fullyautomated/means-of-circuit-design/3D/PowerPak_1212-8/README.md

Source: [https://grabcad.com/library/powerpak_1212-8_single_pad-1]
