fullyautomated/means-of-circuit-design/3D/USB-C/README.md

Source: [https://grabcad.com/library/type-c-31-m-12-1] 

This is not the exact part the footprint is for, but it seems to fit rather well.
