fullyautomated/means-of-circuit-design/3D/PCIe/SMT_POST_36_ASM_sp.step

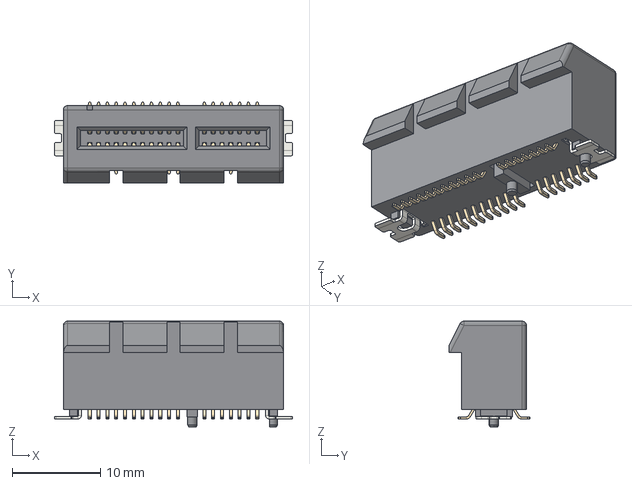
[picture p1: CAD file, 2020-07-23]
3D/PCIe/SMT_POST_36_ASM_sp.step
27.0 x 9.20 x 12.0 mm
