fullyautomated/means-of-circuit-design/3D/Bourns/SRR5028.step

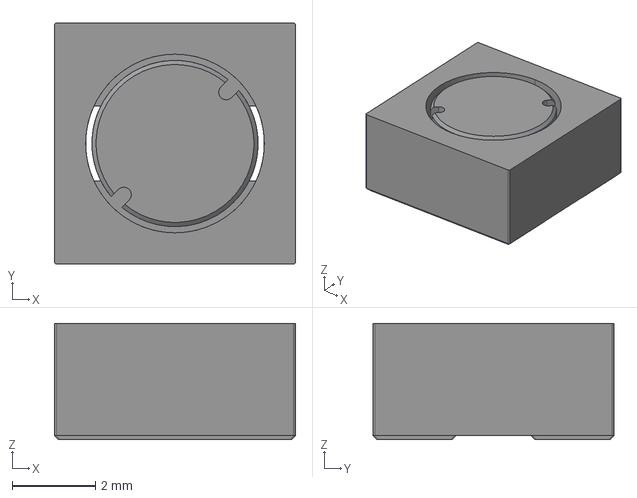
[picture p2: CAD file, 2021-05-05]
3D/Bourns/SRR5028.step
5.80 x 5.80 x 2.80 mm
