fullyautomated/means-of-circuit-design/3D/BQ25792/model.FCStd

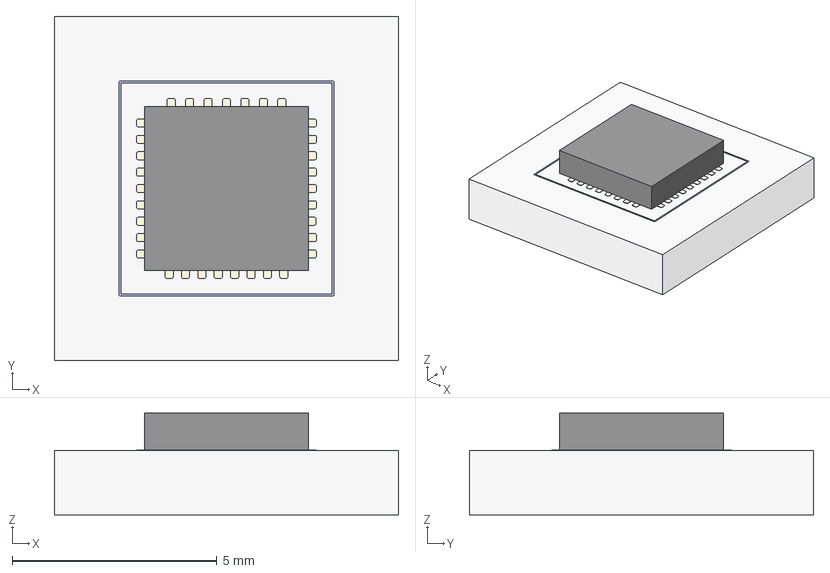
[picture p3: CAD file, 2020-07-23]
3D/BQ25792/model.FCStd
8.40 x 8.40 x 2.49 mm
FCrtYd
TopPads
Pcb
