fullyautomated/means-of-circuit-design/3D/Coilcraft/SER2211.FCStd

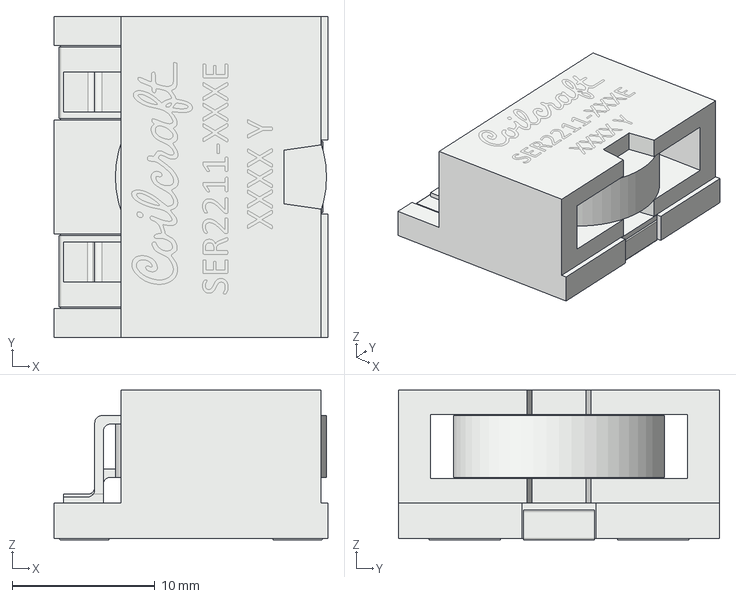
[picture p4: CAD file, 2021-05-05]
3D/Coilcraft/SER2211.FCStd
19.2 x 22.5 x 10.5 mm
