fullyautomated/means-of-circuit-design/3D/DCJack/2.5mm.FCStd

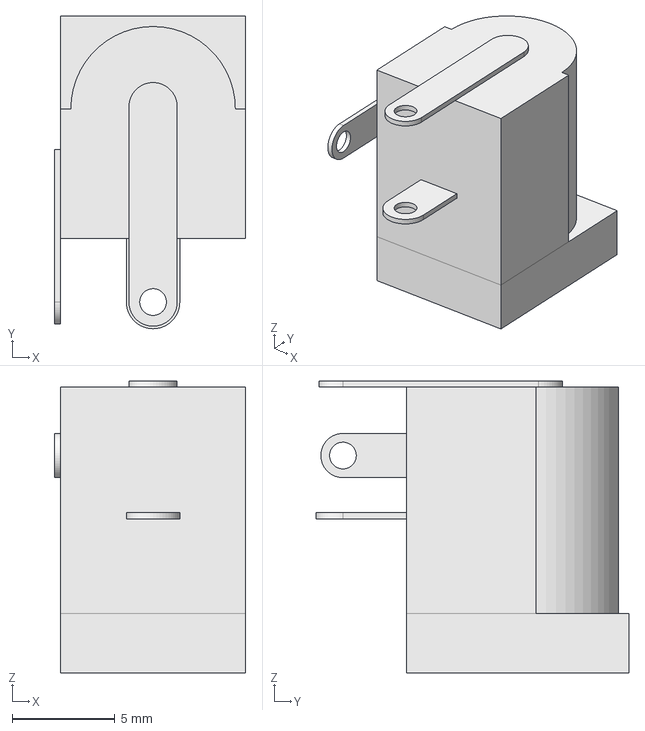
[picture p5: CAD file, 2020-06-24]
3D/DCJack/2.5mm.FCStd
9.30 x 15.2 x 14.2 mm
