fullyautomated/means-of-circuit-design/3D/DSOP_Advance/body.step

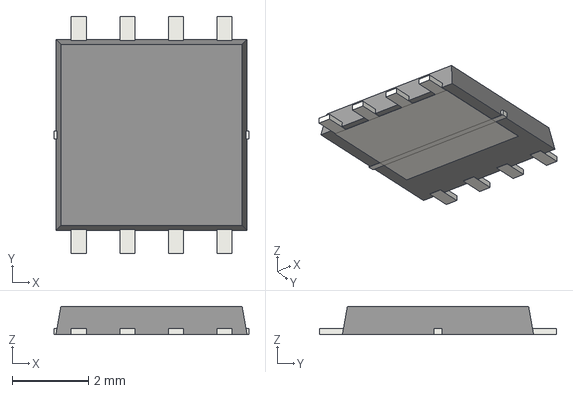
[picture p6: CAD file, 2020-06-24]
3D/DSOP_Advance/body.step
5.10 x 6.20 x 0.74 mm
