fullyautomated/means-of-circuit-design/3D/ESP8266/ESP8266-12.FCStd

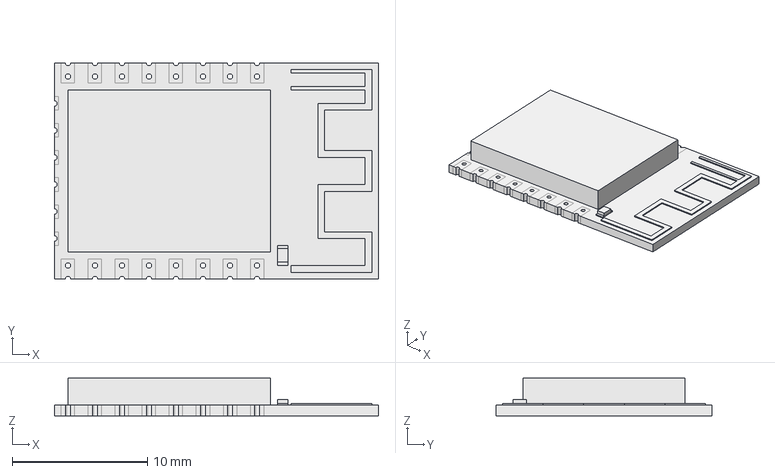
[picture p7: CAD file, 2020-06-24]
3D/ESP8266/ESP8266-12.FCStd
24.0 x 16.0 x 2.80 mm
