fullyautomated/means-of-circuit-design/3D/FastON/FastON_6.3mm_PCBmount_RightAngle_Osterrath_61-1573-11_0031.step

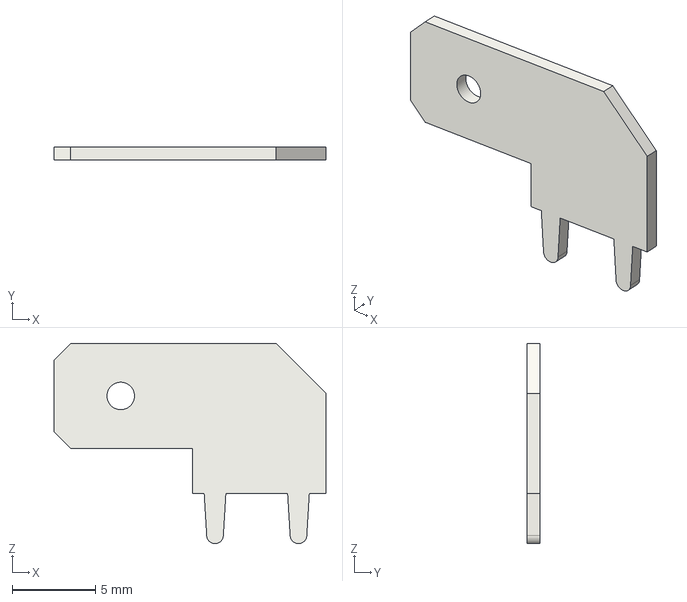
[picture p8: CAD file, 2021-01-31]
3D/FastON/FastON_6.3mm_PCBmount_RightAngle_Osterrath_61-1573-11_0031.step
16.3 x 0.8 x 12.0 mm
