fullyautomated/means-of-circuit-design/3D/Generic/SOT428.step

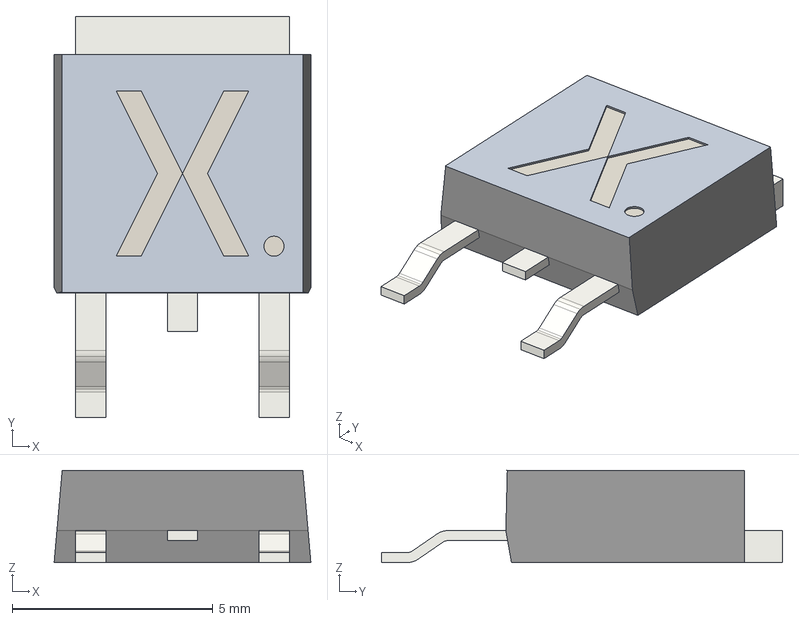
[picture p9: CAD file, 2020-08-01]
3D/Generic/SOT428.step
6.40 x 10.0 x 2.30 mm
