fullyautomated/means-of-circuit-design/3D/Heatsink/960-23-23-D-AB-0.step

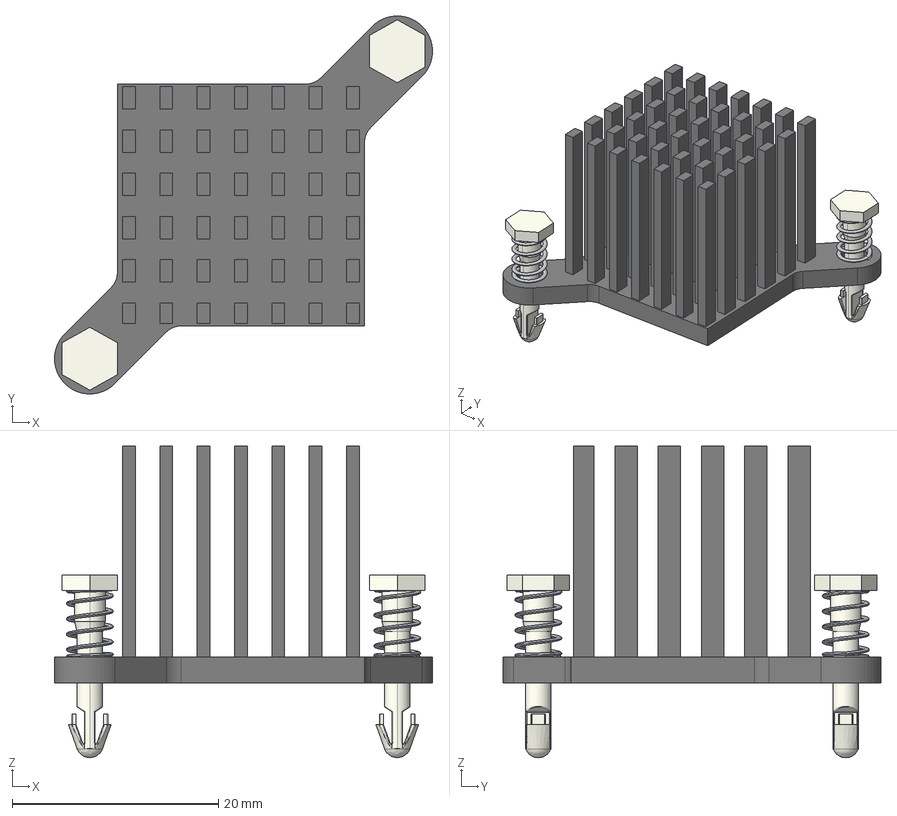
[picture p10: CAD file, 2020-08-03]
3D/Heatsink/960-23-23-D-AB-0.step
36.7 x 36.7 x 30.2 mm
