fullyautomated/means-of-circuit-design/3D/Hirose/WNCB-2000021.stp

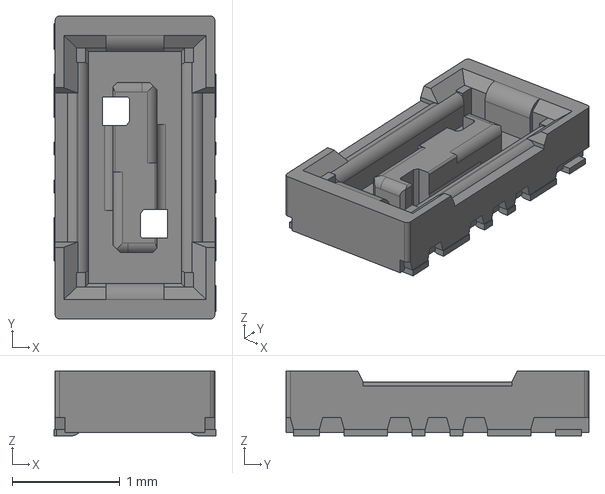
[picture p11: CAD file, 2026-10-10]
3D/Hirose/WNCB-2000021.stp
1.50 x 2.81 x 0.6 mm
