fullyautomated/means-of-circuit-design/3D/Housing/CNMB-CB_Base_cp.step

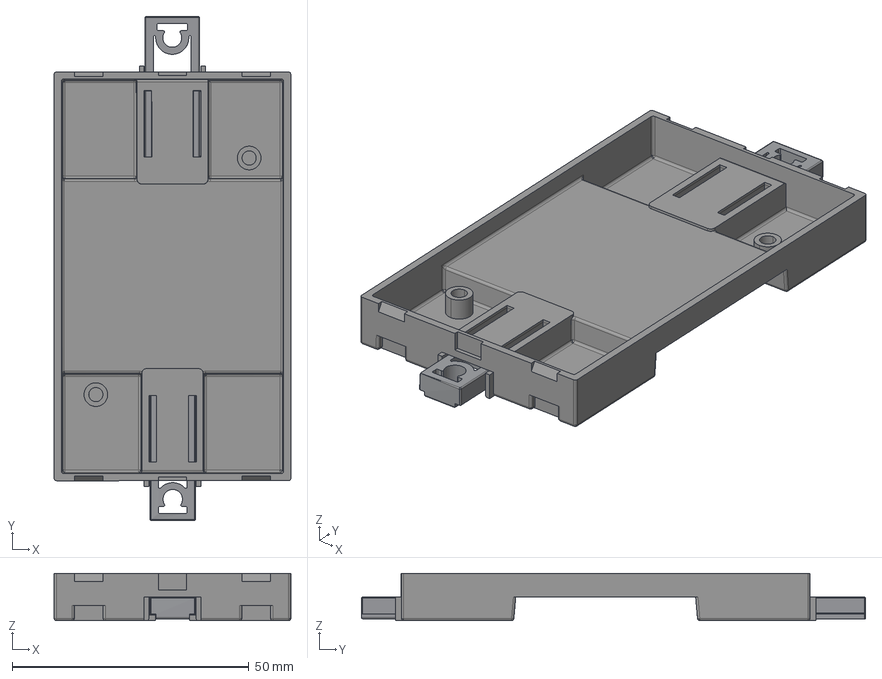
[picture p12: CAD file, 2020-07-31]
3D/Housing/CNMB-CB_Base_cp.step
50.0 x 106.5 x 10.0 mm
