fullyautomated/means-of-circuit-design/3D/JST/SM04B-ULHK-1GFA1-ETB(HF).STEP

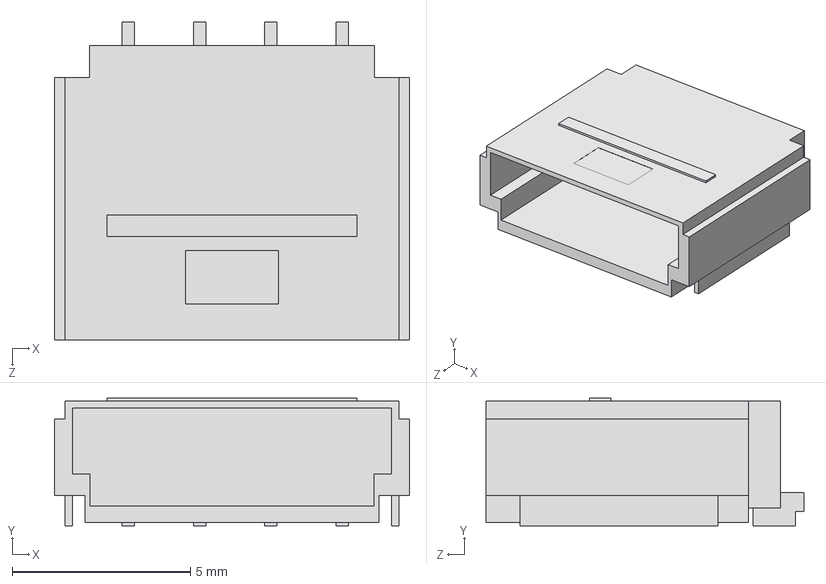
[picture p13: CAD file, 2026-10-10]
3D/JST/SM04B-ULHK-1GFA1-ETB(HF).STEP
9.95 x 3.58 x 8.90 mm
