fullyautomated/means-of-circuit-design/3D/LEDs/LM301H.step

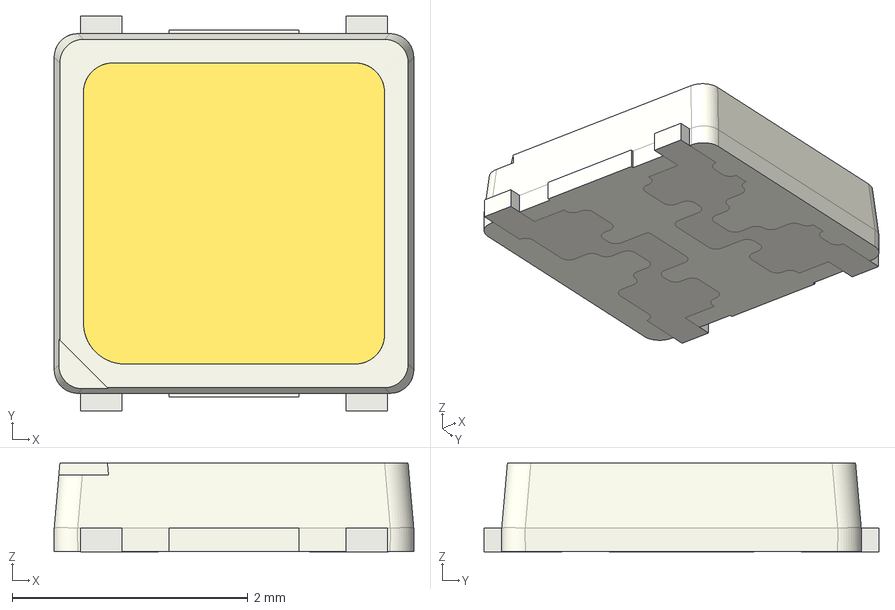
[picture p14: CAD file, 2021-02-14]
3D/LEDs/LM301H.step
3.05 x 3.35 x 0.751 mm
