fullyautomated/means-of-circuit-design/3D/Murata/DLW5BSM191SQ2L.step

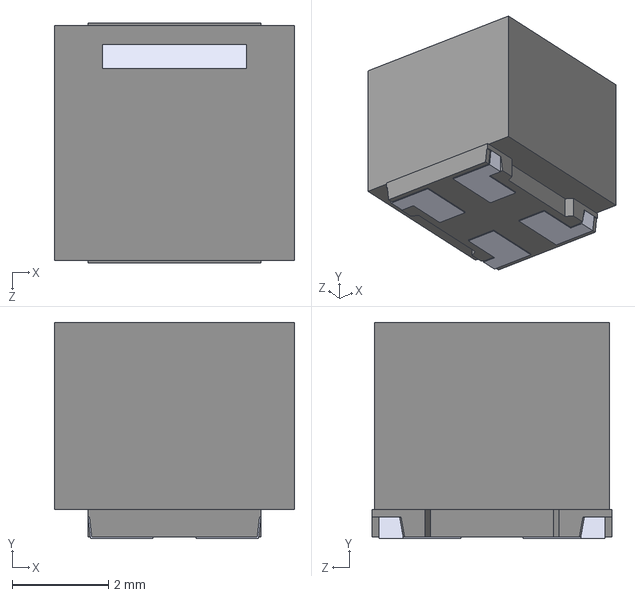
[picture p15: CAD file, 2020-12-17]
3D/Murata/DLW5BSM191SQ2L.step
5.00 x 4.50 x 5.00 mm
