fullyautomated/means-of-circuit-design/3D/Panasonic_PCC-M0530M/M0530M.fcstd

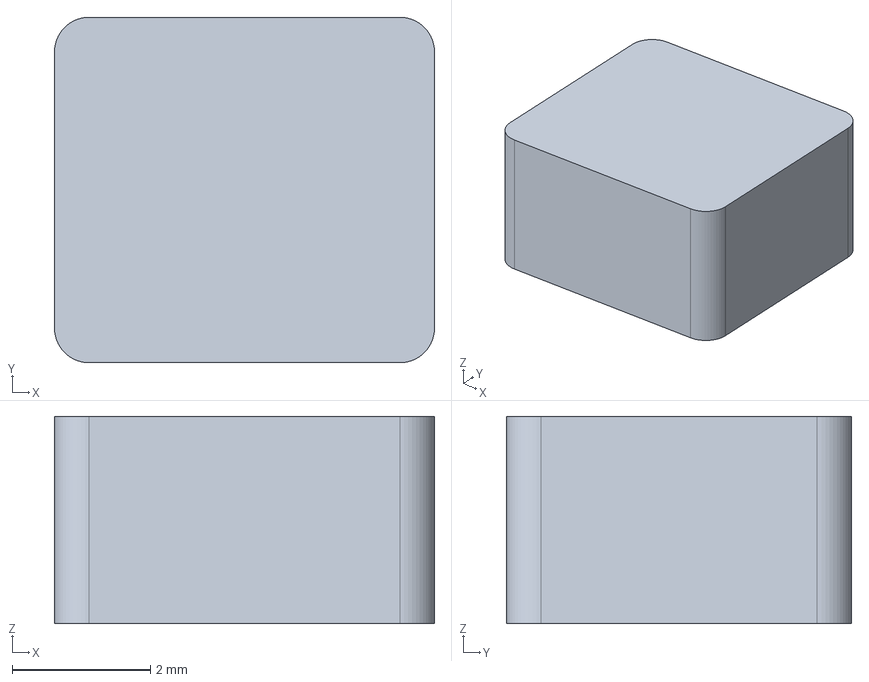
[picture p16: CAD file, 2020-06-24]
3D/Panasonic_PCC-M0530M/M0530M.fcstd
5.50 x 5.00 x 3.00 mm
