fullyautomated/means-of-circuit-design/3D/PCIe/Amphenol_10018783-10210TLF.FCStd

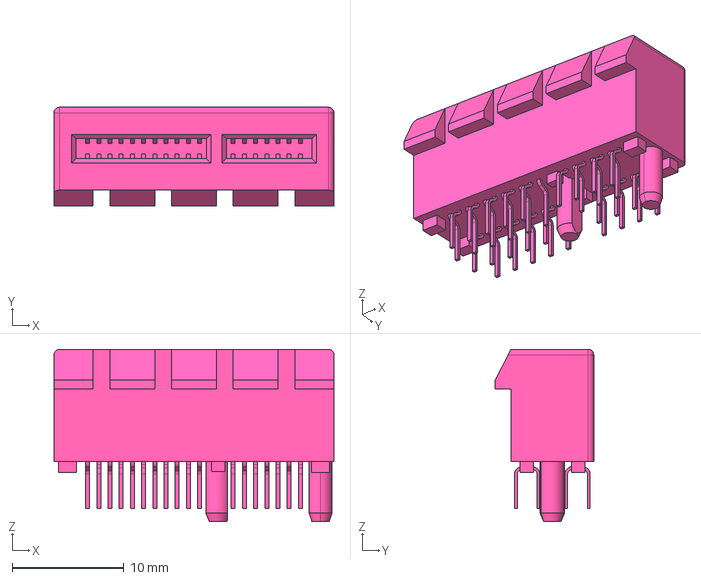
[picture p17: CAD file, 2020-08-02]
3D/PCIe/Amphenol_10018783-10210TLF.FCStd
25.0 x 8.80 x 15.4 mm
