fullyautomated/means-of-circuit-design/3D/PhoenixContact/ccva_2.5-2-g-5.08_p26_thr001_sp.step

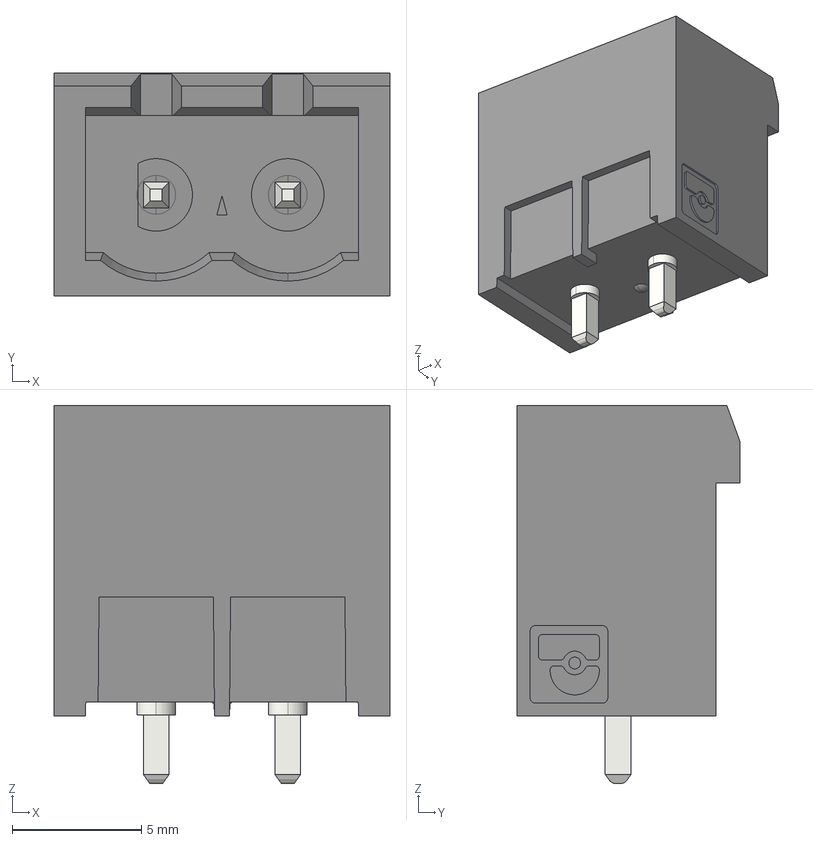
[picture p18: CAD file, 2020-07-23]
3D/PhoenixContact/ccva_2.5-2-g-5.08_p26_thr001_sp.step
13.0 x 8.60 x 14.6 mm
