fullyautomated/means-of-circuit-design/3D/PowerPak_1212-8/PowerPAK_1212-8.step

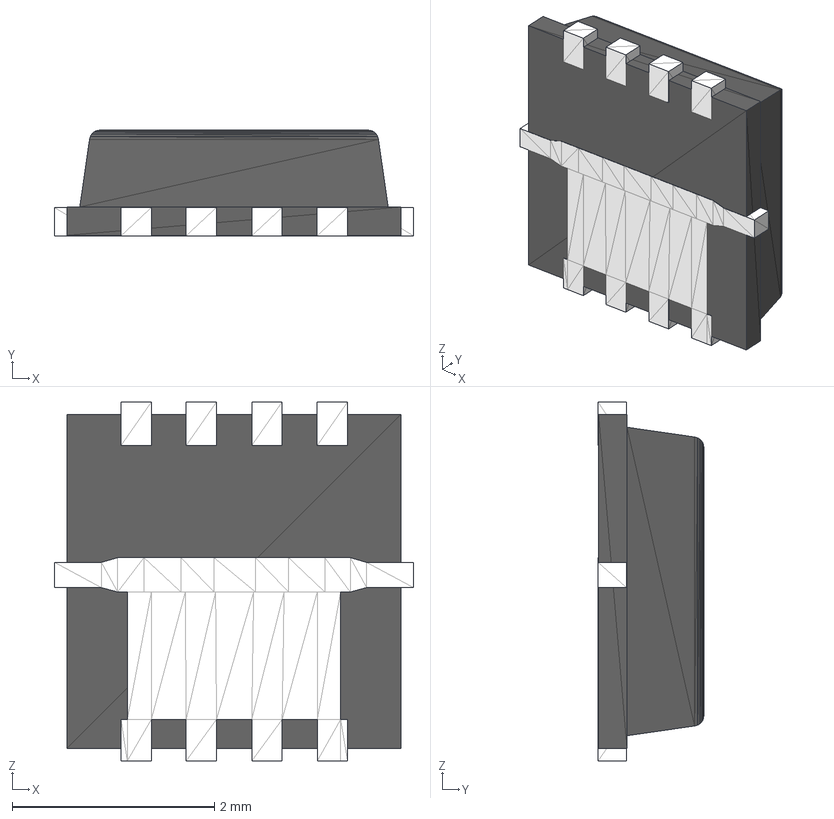
[picture p19: CAD file, 2020-07-23]
3D/PowerPak_1212-8/PowerPAK_1212-8.step
3.55 x 1.05 x 3.55 mm
