fullyautomated/means-of-circuit-design/3D/PTS636/PTS636.FCStd

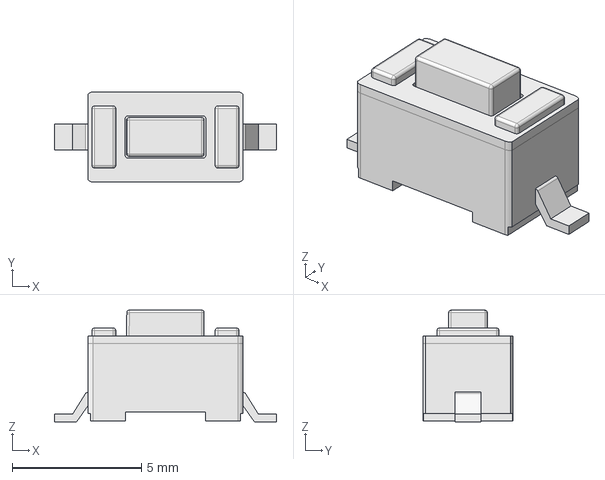
[picture p20: CAD file, 2020-07-23]
3D/PTS636/PTS636.FCStd
8.60 x 3.50 x 4.33 mm
