fullyautomated/means-of-circuit-design/3D/QFN-20-1EP_3x3mm_P0.4mm_EP1.65x1.65mm/QFN40P300X300X75-21T170N.step

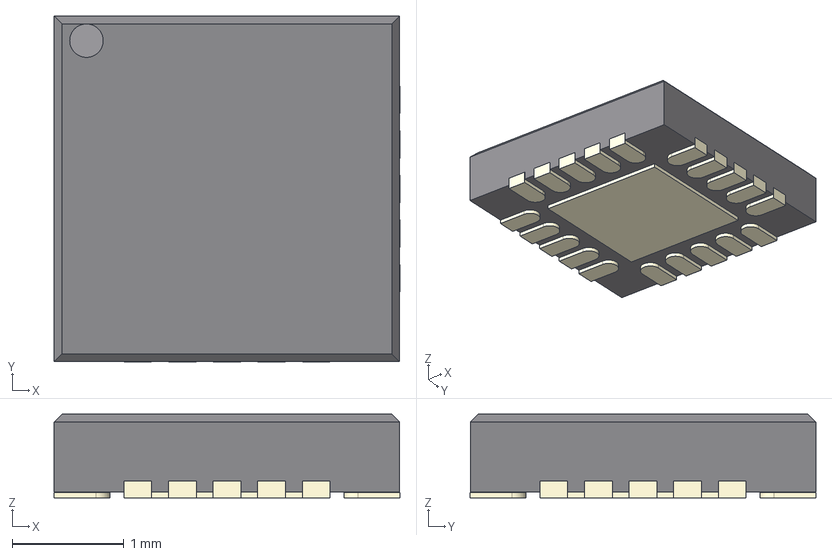
[picture p21: CAD file, 2020-07-23]
3D/QFN-20-1EP_3x3mm_P0.4mm_EP1.65x1.65mm/QFN40P300X300X75-21T170N.step
3.10 x 3.10 x 0.75 mm
