fullyautomated/means-of-circuit-design/3D/Samtec/tsw-113-08-t-t-ra.step

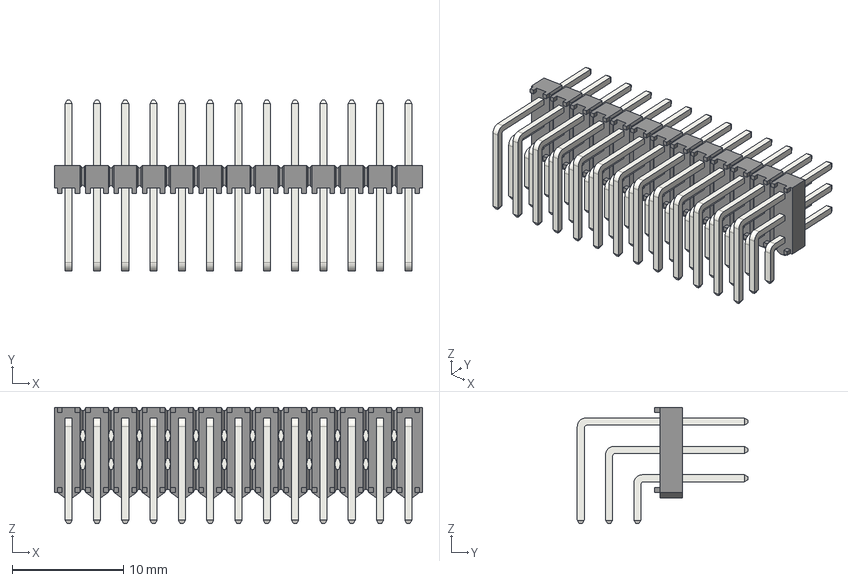
[picture p22: CAD file, 2020-08-03]
3D/Samtec/tsw-113-08-t-t-ra.step
33.0 x 15.3 x 10.4 mm
