fullyautomated/means-of-circuit-design/3D/Sensors/LTR-303ALS-01.step

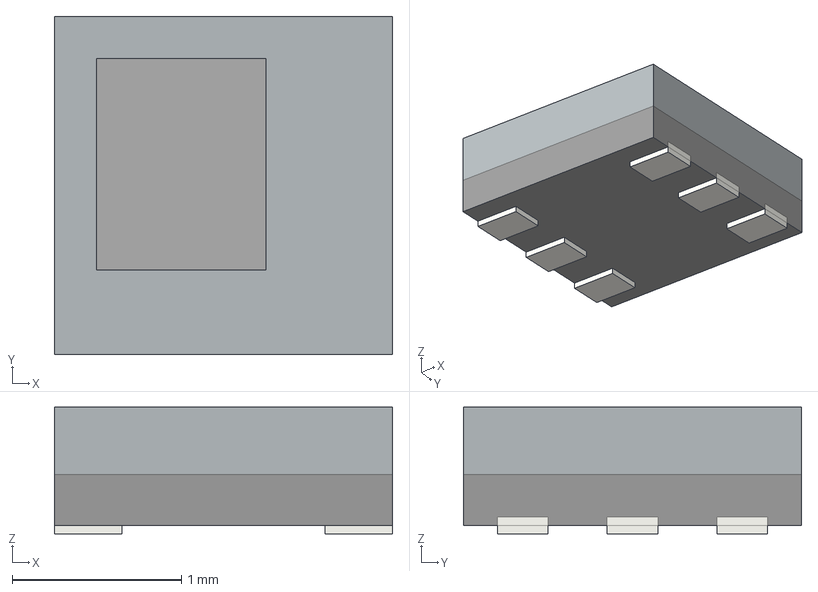
[picture p23: CAD file, 2020-08-25]
3D/Sensors/LTR-303ALS-01.step
2.00 x 2.00 x 0.75 mm
