fullyautomated/means-of-circuit-design/3D/SRP1245/Admi4FFDtvdj.step

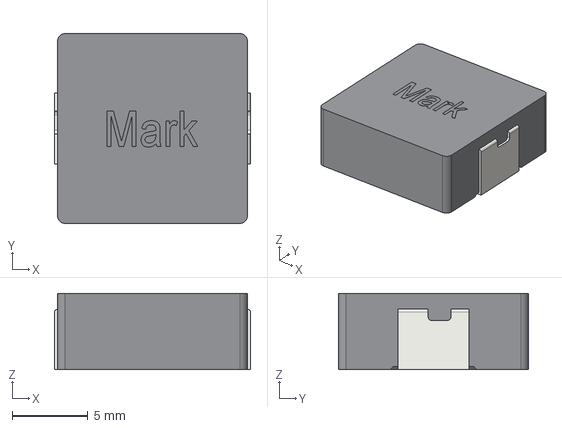
[picture p24: CAD file, 2020-07-23]
3D/SRP1245/Admi4FFDtvdj.step
12.9 x 12.5 x 5.00 mm
