fullyautomated/means-of-circuit-design/3D/TI/RPE0009A.step

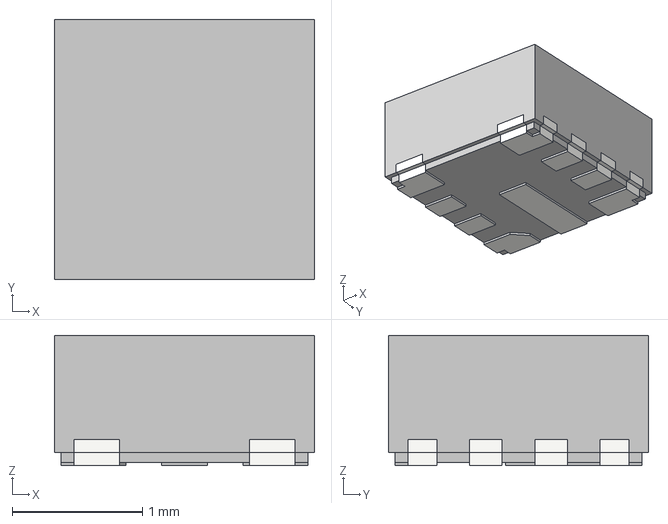
[picture p25: CAD file, 2021-05-03]
3D/TI/RPE0009A.step
2.00 x 2.00 x 1.00 mm
