fullyautomated/means-of-circuit-design/3D/Toshiba/TO-220SM(W).step

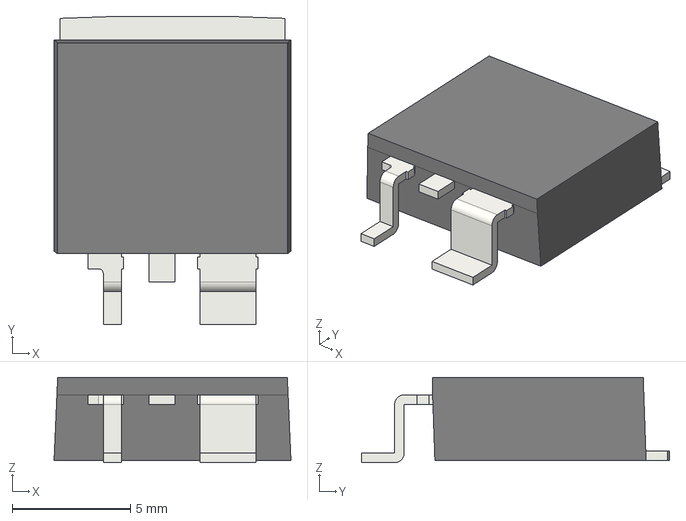
[picture p26: CAD file, 2021-02-14]
3D/Toshiba/TO-220SM(W).step
10.0 x 13.0 x 3.60 mm
