fullyautomated/means-of-circuit-design/3D/TPS62135/Pad.step

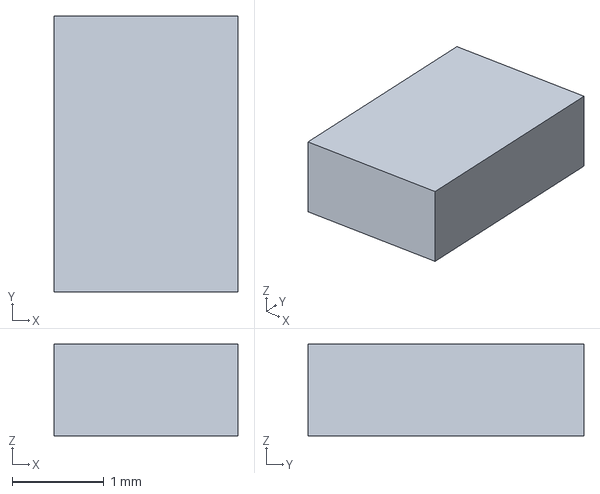
[picture p27: CAD file, 2020-06-24]
3D/TPS62135/Pad.step
2.00 x 3.00 x 1.00 mm
