fullyautomated/means-of-circuit-design/3D/USB-C/HRO_TYPE-C-31-M-12_source.step

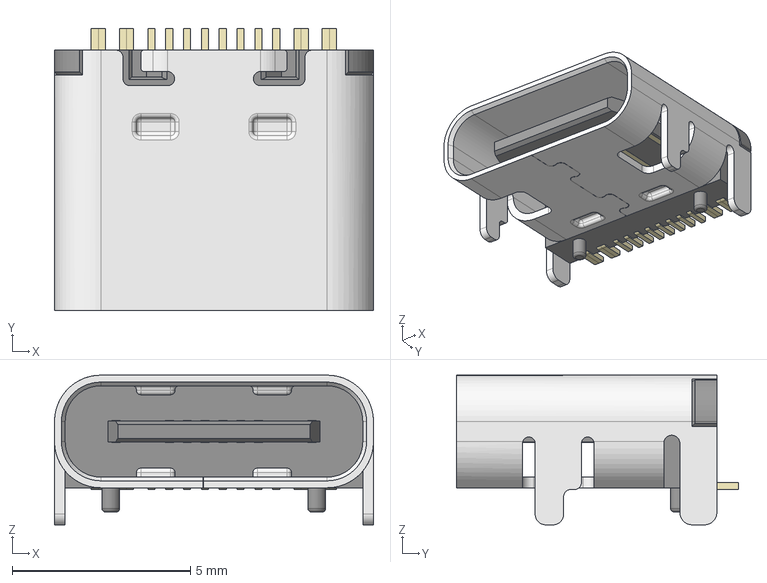
[picture p28: CAD file, 2020-07-23]
3D/USB-C/HRO_TYPE-C-31-M-12_source.step
8.95 x 7.90 x 4.20 mm
