fullyautomated/means-of-circuit-design/3D/Bourns/SRF1260.step

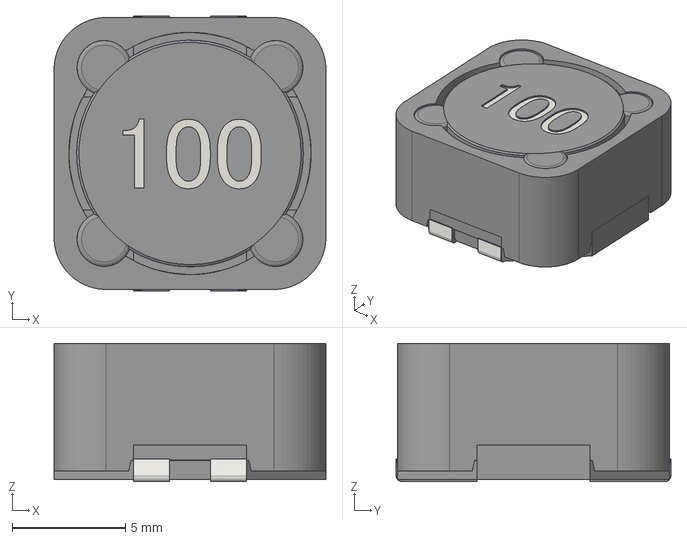
[picture p29: CAD file, 2020-07-31]
3D/Bourns/SRF1260.step
12.0 x 12.1 x 6.09 mm
