fullyautomated/means-of-circuit-design/3D/BQ25792/Part.step

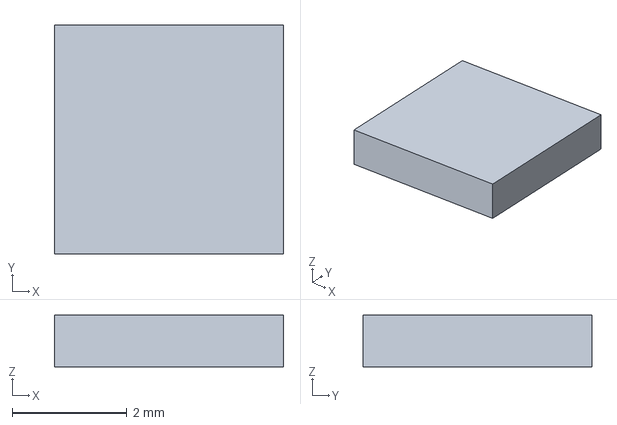
[picture p30: CAD file, 2020-07-23]
3D/BQ25792/Part.step
4.00 x 4.00 x 0.9 mm
