fullyautomated/means-of-circuit-design/3D/Coilcraft/Coilcraft-SER2211.step

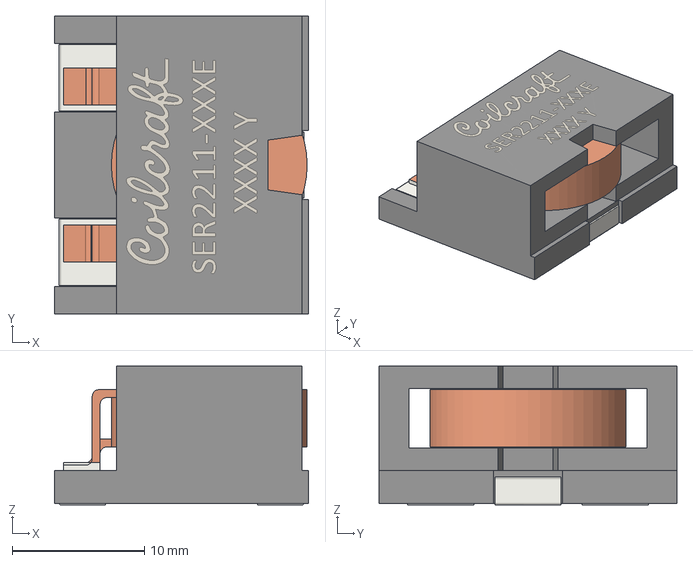
[picture p31: CAD file, 2021-05-05]
3D/Coilcraft/Coilcraft-SER2211.step
19.2 x 22.5 x 10.5 mm
