fullyautomated/means-of-circuit-design/3D/Heatsink/WV_27-23-D-AB-0.step

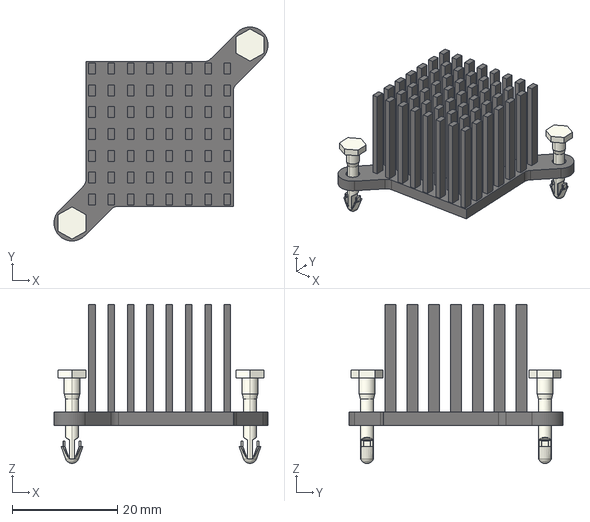
[picture p32: CAD file, 2020-08-03]
3D/Heatsink/WV_27-23-D-AB-0.step
40.7 x 40.7 x 30.2 mm
