fullyautomated/means-of-circuit-design/3D/Housing/CNMB-3V-2-Top.step

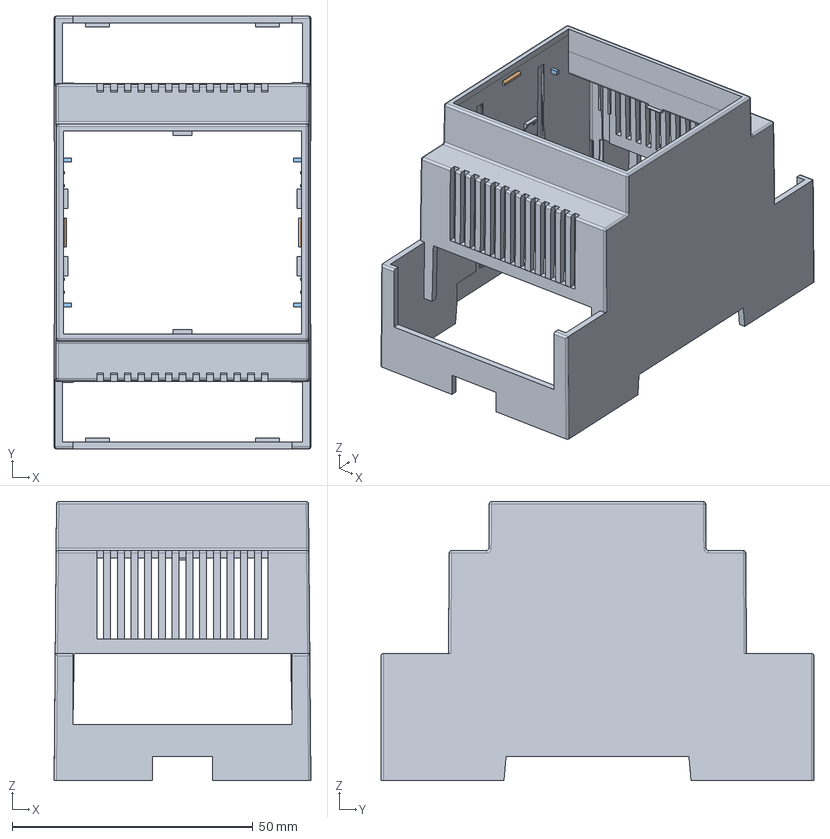
[picture p33: CAD file, 2020-07-31]
3D/Housing/CNMB-3V-2-Top.step
53.4 x 90.0 x 58.0 mm
