fullyautomated/means-of-circuit-design/3D/LEDs/OSRAM_Duris_S5.step

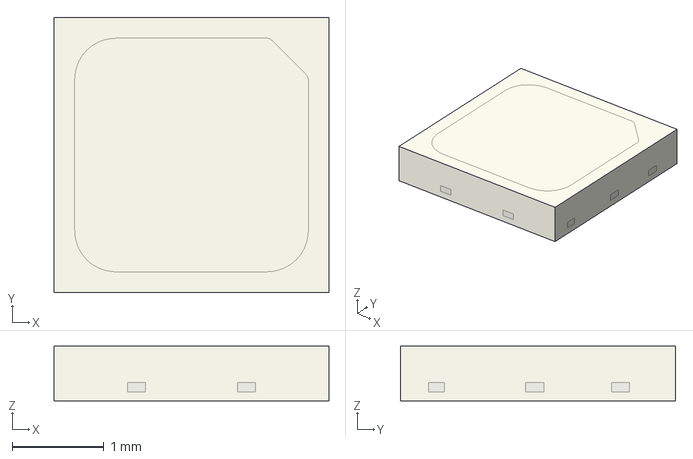
[picture p34: CAD file, 2020-08-02]
3D/LEDs/OSRAM_Duris_S5.step
3.00 x 3.00 x 0.6 mm
