fullyautomated/means-of-circuit-design/3D/Sensors/AS7341.step

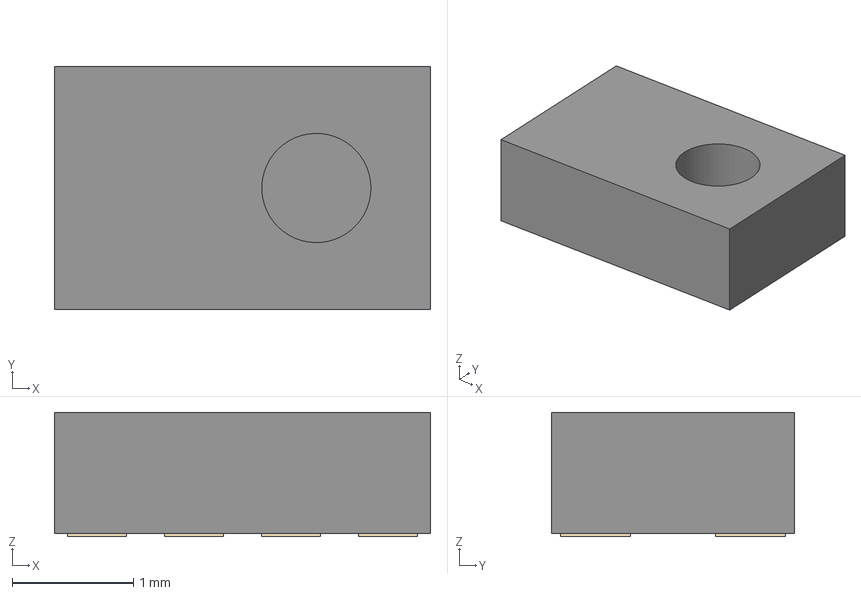
[picture p35: CAD file, 2020-08-13]
3D/Sensors/AS7341.step
3.10 x 2.00 x 1.02 mm
