fullyautomated/means-of-circuit-design/3D/Coilcraft/SER2915H.FCStd

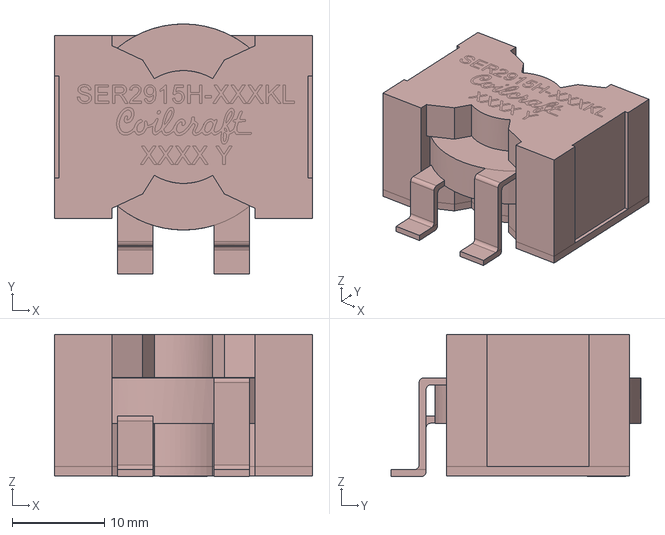
[picture p36: CAD file, 2020-07-31]
3D/Coilcraft/SER2915H.FCStd
27.9 x 27.0 x 15.4 mm
