fullyautomated/means-of-circuit-design/3D/PhoenixContact/pxc_1955918_07_CCVA-2-5-8-G-5-08-P26THR_3D.stp

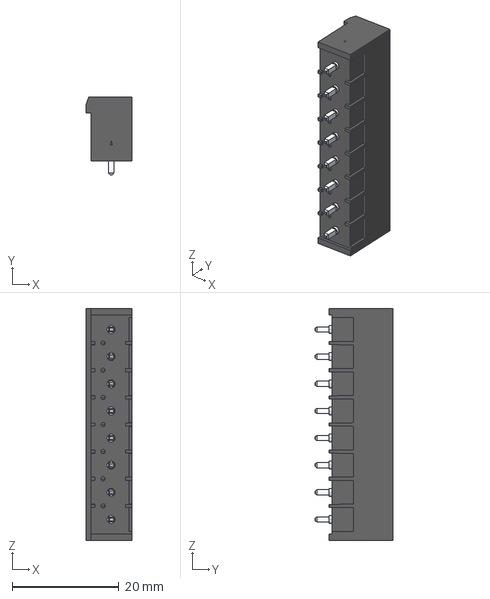
[picture p37: CAD file, 2020-07-23]
3D/PhoenixContact/pxc_1955918_07_CCVA-2-5-8-G-5-08-P26THR_3D.stp
8.60 x 14.6 x 43.4 mm
