fullyautomated/means-of-circuit-design/3D/Coilcraft/SER3018H.FCStd

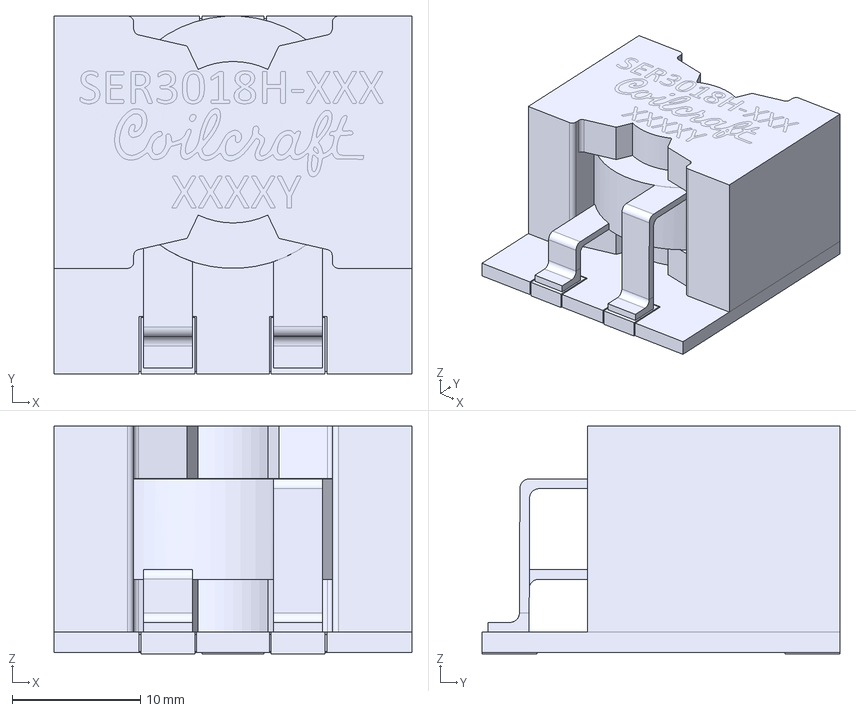
[picture p38: CAD file, 2020-07-31]
3D/Coilcraft/SER3018H.FCStd
27.9 x 27.9 x 17.8 mm
