fullyautomated/means-of-circuit-design/3D/PhoenixContact/pxc_1955895_07_CCVA-2-5-6-G-5-08-P26THR_3D.stp

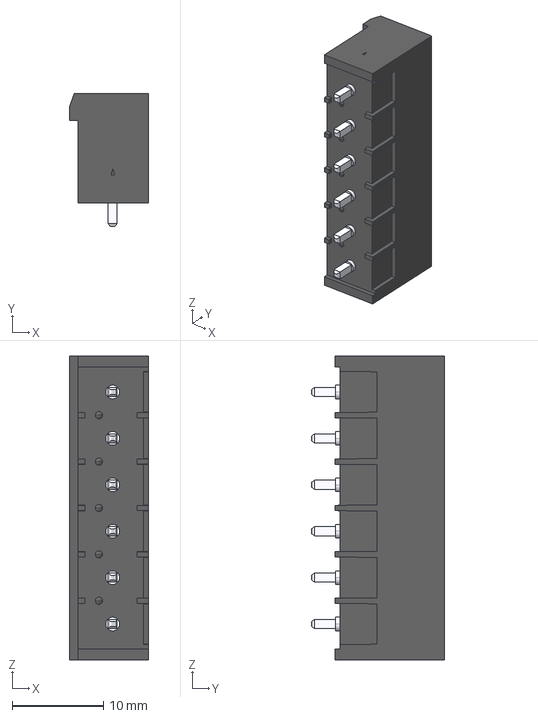
[picture p39: CAD file, 2020-07-23]
3D/PhoenixContact/pxc_1955895_07_CCVA-2-5-6-G-5-08-P26THR_3D.stp
8.60 x 14.6 x 33.3 mm
