fullyautomated/means-of-circuit-design/3D/TI/PWP0020A.stp

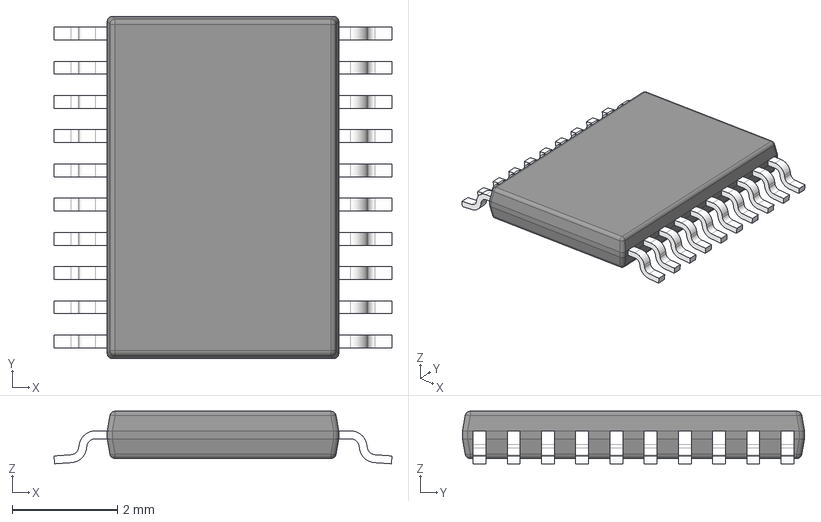
[picture p40: CAD file, 2020-07-31]
3D/TI/PWP0020A.stp
6.42 x 6.50 x 1.00 mm
BODY-SO
LEAD-SO x 20
THERMALPAD-SO
PIN1-ID
