fullyautomated/means-of-circuit-design/(list of files, cad)

Other CAD files:
3D/DCJack/Fusion001.step
3D/ESP8266/Fusion028.step
3D/Panasonic_PCC-M0530M/Body_sp.step
3D/PCIe/Amph_10018783-10210TLF.step
3D/PhoenixContact/pxc_1955853_07_CCVA-2-5-2-G-5-08-P26THR_3D.stp
3D/PowerPak_1212-8/single_pad001001_sp.step
3D/PTS636/PTS636SK50SMTRLFS_cp.step
3D/SRP1245/SRP1245.FCStd
3D/TPS62135/RGX.fcstd
3D/USB-C/HRO_TYPE-C-31-M-12.FCStd
3D/Heatsink/27-23-D-AB-0.FCStd
3D/PTS636/PTS636SP50SMTRLFS.stp
3D/USB-C/ConPins_sp.step
3D/PCIe/Amphenol_10061913.FCStd
3D/PhoenixContact/ccva_2.5-6-g-5.08_p26_thr001_sp.step
3D/PhoenixContact/ccva_2.5-8-g-5.08_p26_thr001_sc.step
3D/Bourns/SRF1260.FCStd
3D/Bourns/SRR5028.FCStd
3D/FastON/FastON_6.3mm_PCBmount_RightAngle_Osterrath_61-1573-11_0031.FCStd
3D/Generic/SOT428.FCStd
3D/Heatsink/960-23-23-D-AB-0.FCStd
3D/LEDs/LM301H.FCStd
3D/LEDs/OSRAM_Duris_S5.FCStd
3D/PCIe/10061913-xx0.stp
3D/PhoenixContact/1955853.FCStd
3D/PhoenixContact/1955895.FCStd
3D/PhoenixContact/1955918.FCStd
3D/PowerPak_1212-8/PowerPAK_1212-8.FCStd
3D/QFN-20-1EP_3x3mm_P0.4mm_EP1.65x1.65mm/QFN40P300X300X75-21T170N.FCStd
3D/QFN-20-1EP_3x3mm_P0.4mm_EP1.65x1.65mm/QFN40P300X300X75-21T170N.obj
3D/Samtec/tsw-113-08-t-t-ra.FCStd
3D/Sensors/AS7341.FCStd
3D/Sensors/LTR-303ALS-01.FCStd
3D/TI/LM76005.FCStd
3D/TI/LM76005_RNP0030A.step
3D/TI/RPE0009A.FCStd
3D/TI/RPE0009A.stp
3D/Toshiba/TO-220SM(W).FCStd
3D/Wuerth/62002821121_.stp
3D/Wuerth/7466205.FCStd
3D/Wuerth/7466205.step
3D/Wuerth/79527141.FCStd
3D/Wuerth/79527141.stp
