fullyautomated/means-of-circuit-design/3D/Housing/CNMB-3-2.PDF

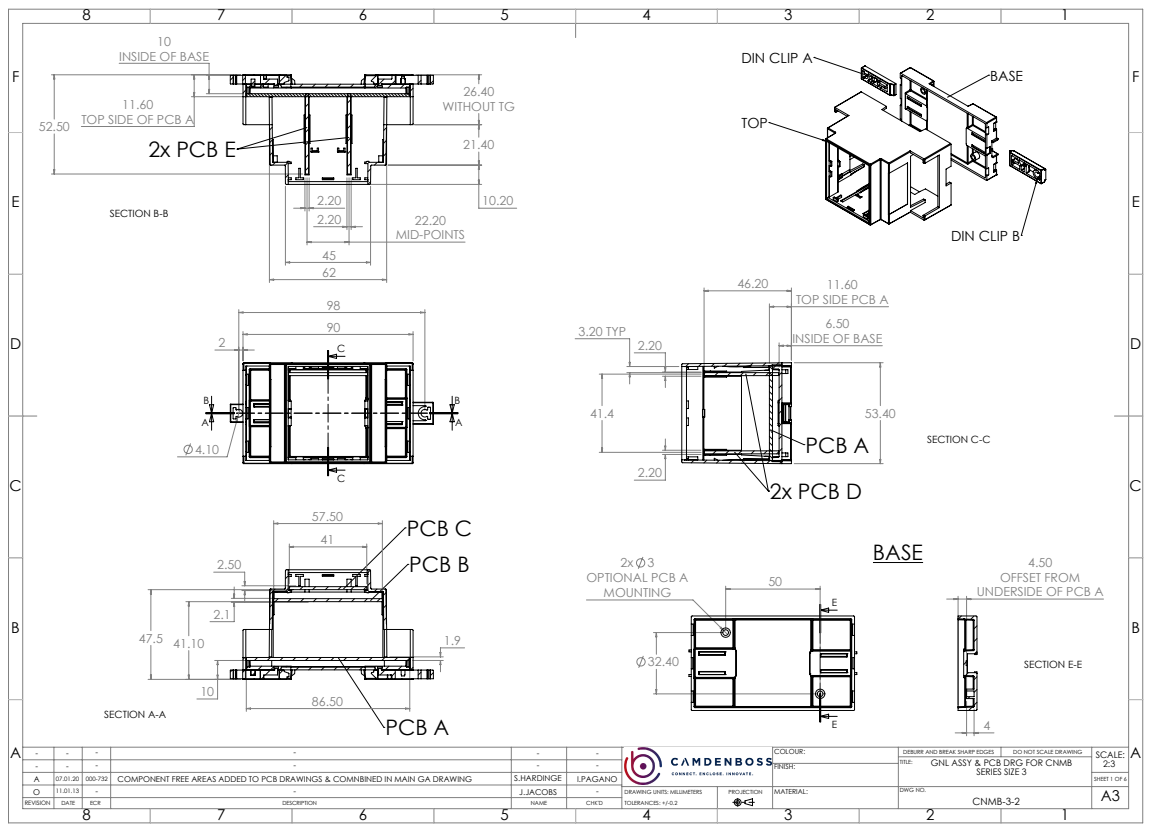
[picture p41: page 1]
SECTION A-A; PCB A; PCB B; PCB C; WITHOUT TG; SECTION B-B; 2x PCB E; 3.20 TYP; SECTION C-C; 2x PCB D; 2x 3 OPTIONAL PCB A; SECTION E-E; DIN CLIP B; DIN CLIP A

INSIDE OF BASE

TOP SIDE OF PCB A 52.50

TOP SIDE PCB A

OFFSET FROM
UNDERSIDE OF PCB A

- - | - | - | | - | - | | COLOUR: | DEBURR AND BREAK SHARP EDGES | DO NOT SCALE DRAWING | SCALE: 2:3
A | 07.01.20 | 000-732 | COMPONENT FREE AREAS ADDED TO PCB DRAWINGS & COMNBINED IN MAIN GA DRAWING | S.HARDINGE | I.PAGANO | | | | | SHEET 1 OF 6
O | 11.01.13 | - J.JACOBS | - | | - | DRAWING UNITS: MILLIMETERS TOLERANCES: +/-0.2 | PROJECTION | MATERIAL: | DWG NO. CNMB-3-2 | A3
REVISION | DATE | ECR | DESCRIPTION | NAME | CHK'D

GNL ASSY & PCB DRG FOR CNMB

SERIES SIZE 3 www.CamdenBoss.com

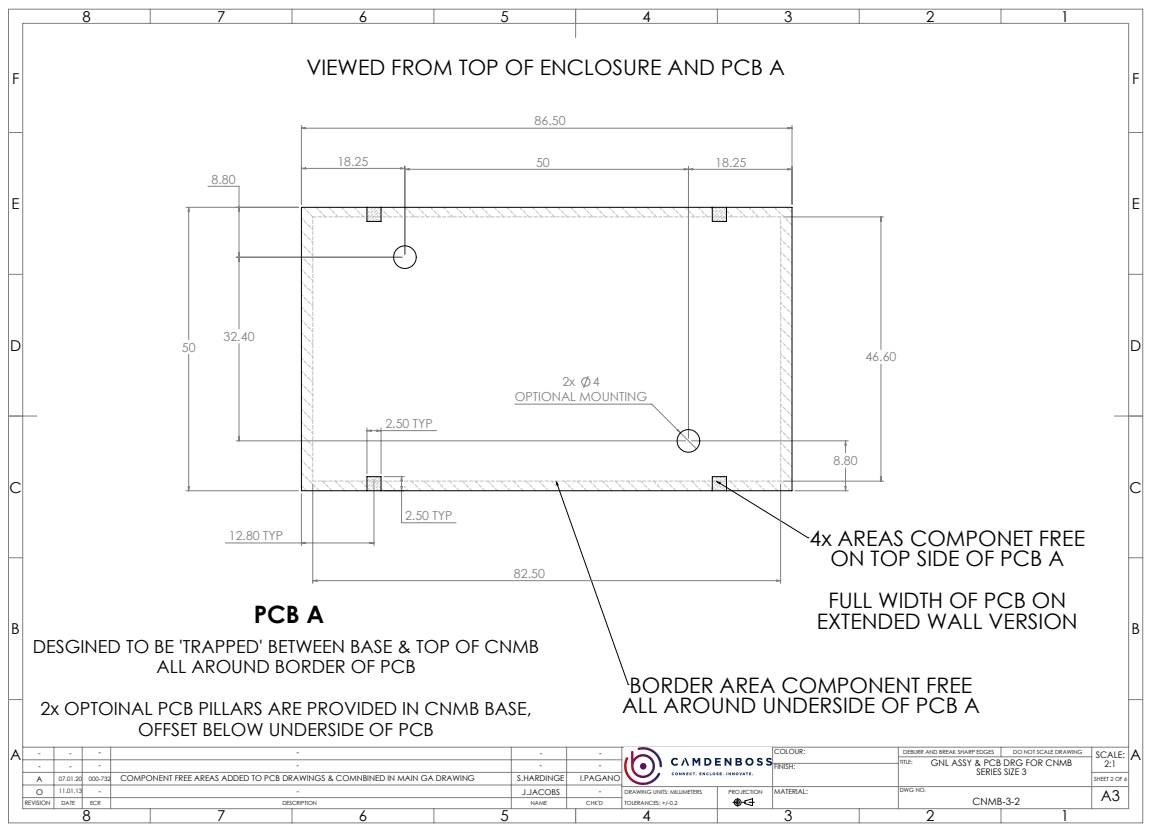
[picture p42: page 2]
2x 4 OPTIONAL MOUNTING; 2.50 TYP; 12.80 TYP; PCB A

VIEWED FROM TOP OF ENCLOSURE AND PCB A

4x AREAS COMPONET FREE
ON TOP SIDE OF PCB A
FULL WIDTH OF PCB ON
EXTENDED WALL VERSION

DESGINED TO BE 'TRAPPED' BETWEEN BASE & TOP OF CNMB

ALL AROUND BORDER OF PCB

BORDER AREA COMPONENT FREE
ALL AROUND UNDERSIDE OF PCB A

2x OPTOINAL PCB PILLARS ARE PROVIDED IN CNMB BASE,

OFFSET BELOW UNDERSIDE OF PCB

- - | - | - | | - | - | COLOUR: | DEBURR AND BREAK SHARP EDGES | DO NOT SCALE DRAWING | SCALE: 2:1

GNL ASSY & PCB DRG FOR CNMB

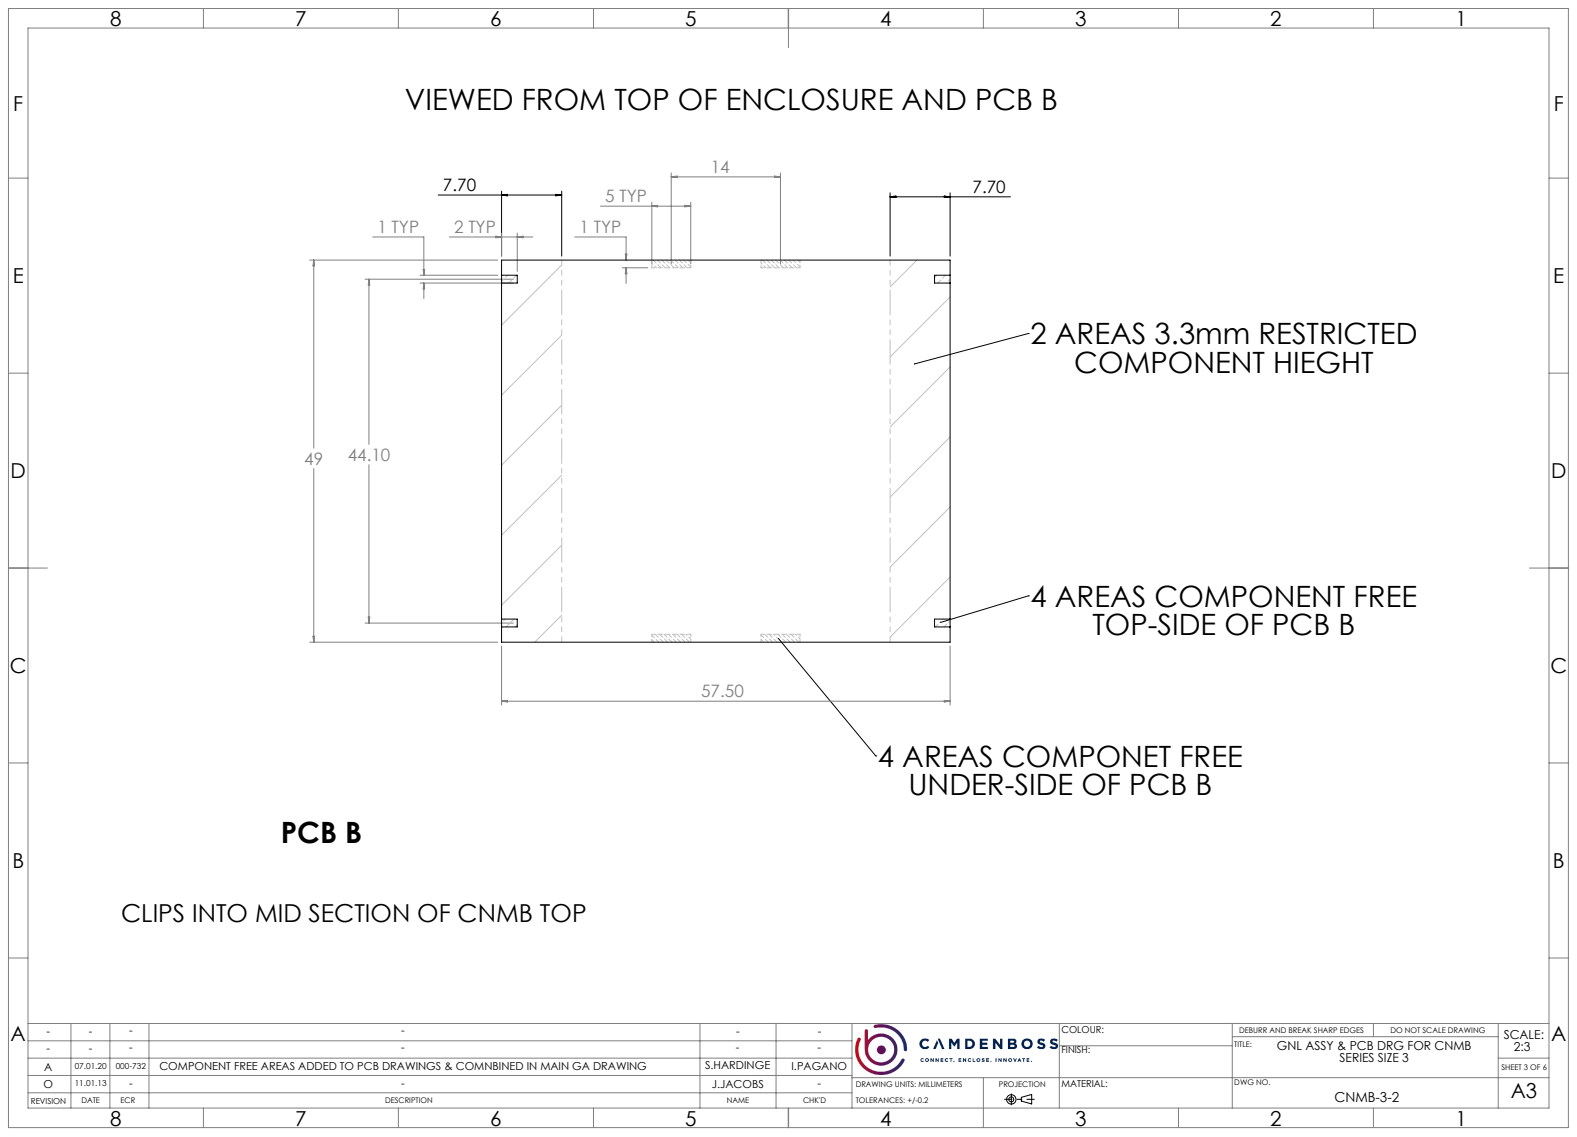
[picture p43: page 3]
2 TYP; 1 TYP; 5 TYP; 2 AREAS 3.3mm RESTRICTED COMPONENT HIEGHT; PCB B

VIEWED FROM TOP OF ENCLOSURE AND PCB B

4 AREAS COMPONENT FREE
TOP-SIDE OF PCB B

4 AREAS COMPONET FREE
UNDER-SIDE OF PCB B

CLIPS INTO MID SECTION OF CNMB TOP

- - | - | - | | - | - | COLOUR: | DEBURR AND BREAK SHARP EDGES | DO NOT SCALE DRAWING | SCALE: 2:3

GNL ASSY & PCB DRG FOR CNMB

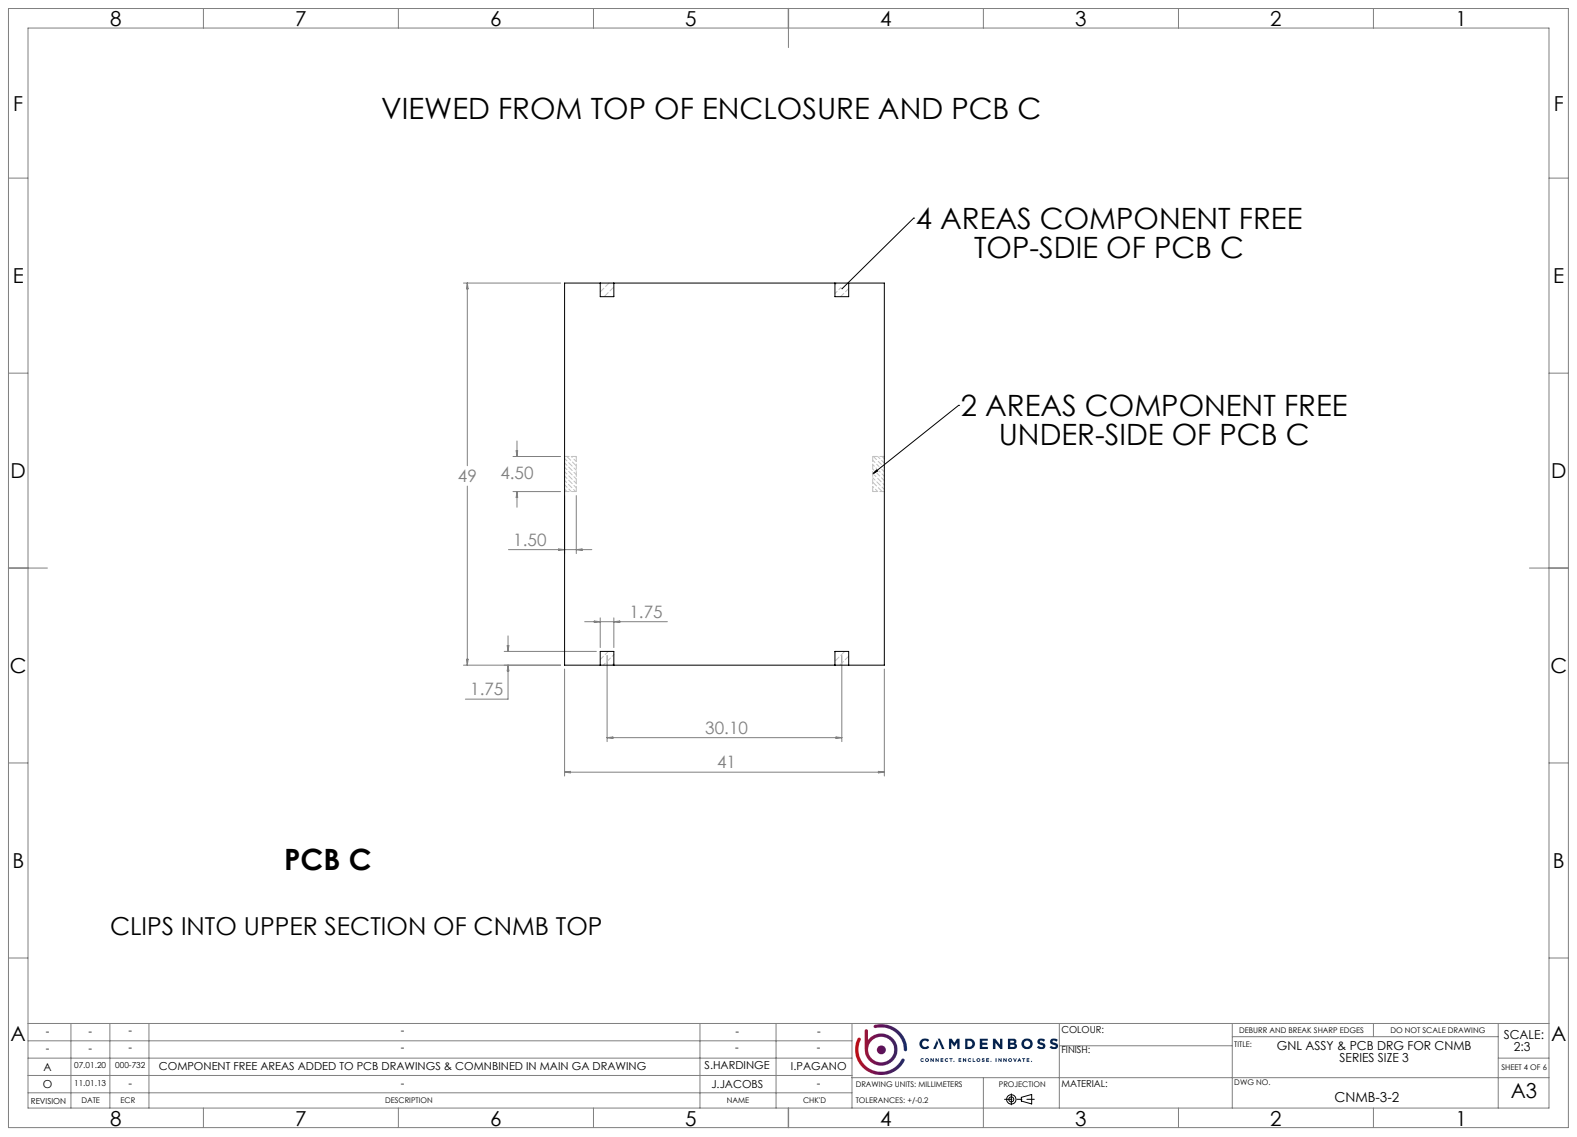
[picture p44: page 4]
PCB C

VIEWED FROM TOP OF ENCLOSURE AND PCB C

4 AREAS COMPONENT FREE
TOP-SDIE OF PCB C

2 AREAS COMPONENT FREE
UNDER-SIDE OF PCB C

CLIPS INTO UPPER SECTION OF CNMB TOP

- - | - | - | | - | - | COLOUR: | DEBURR AND BREAK SHARP EDGES | DO NOT SCALE DRAWING | SCALE: 2:3

GNL ASSY & PCB DRG FOR CNMB

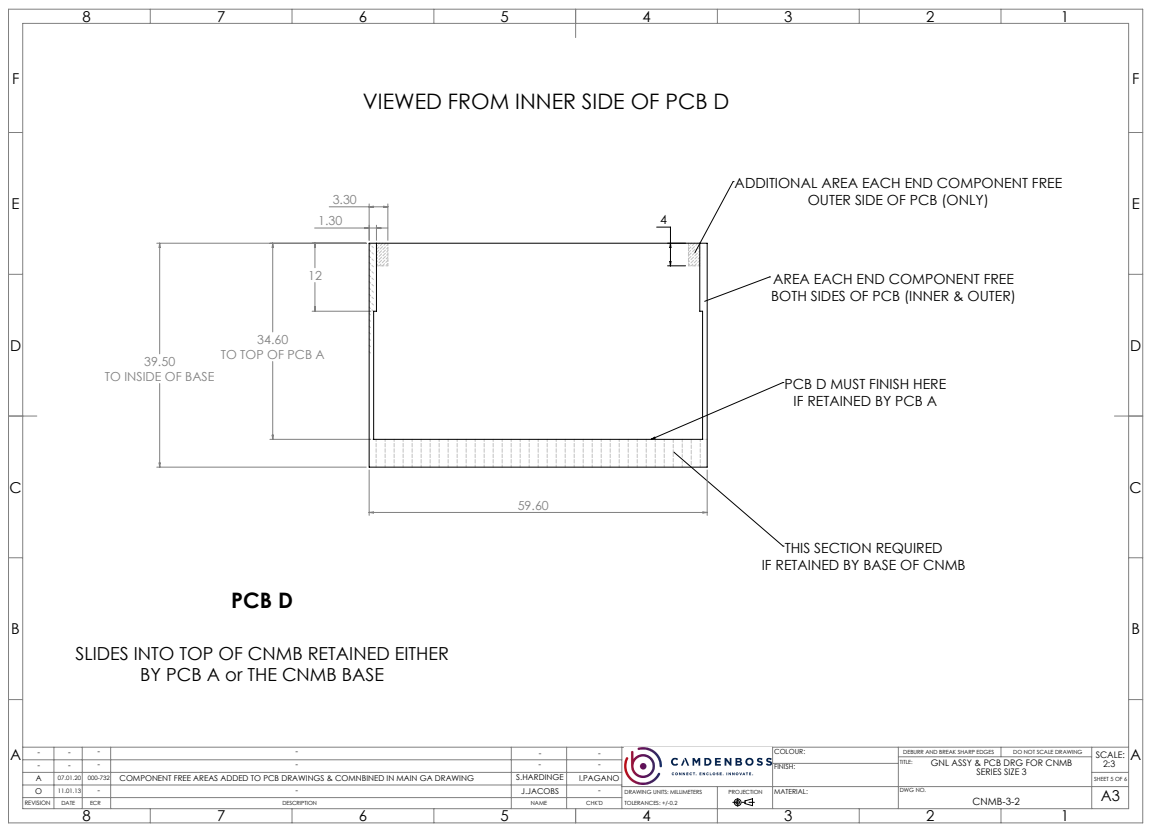
[picture p45: page 5]
PCB D

VIEWED FROM INNER SIDE OF PCB D

ADDITIONAL AREA EACH END COMPONENT FREE

OUTER SIDE OF PCB (ONLY)

AREA EACH END COMPONENT FREE
BOTH SIDES OF PCB (INNER & OUTER)

TO TOP OF PCB A 39.50
TO INSIDE OF BASE

PCB D MUST FINISH HERE
IF RETAINED BY PCB A

THIS SECTION REQUIRED
IF RETAINED BY BASE OF CNMB

SLIDES INTO TOP OF CNMB RETAINED EITHER
BY PCB A or THE CNMB BASE

- - | - | - | | - | - | COLOUR: | DEBURR AND BREAK SHARP EDGES | DO NOT SCALE DRAWING | SCALE: 2:3

GNL ASSY & PCB DRG FOR CNMB

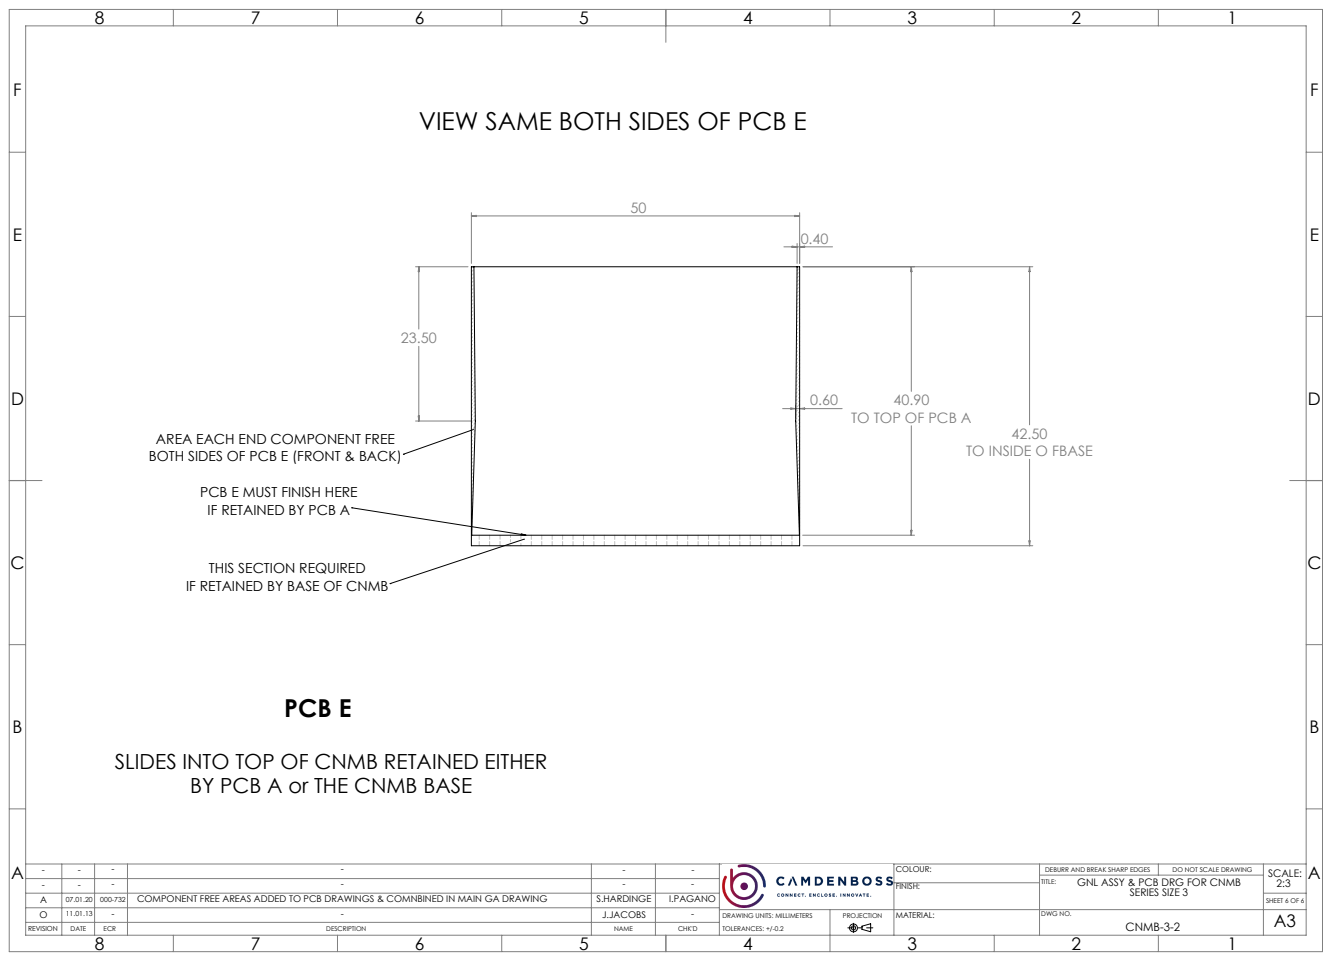
[picture p46: page 6]
PCB E

VIEW SAME BOTH SIDES OF PCB E

TO TOP OF PCB A

TO INSIDE O FBASE

AREA EACH END COMPONENT FREE
BOTH SIDES OF PCB E (FRONT & BACK)

PCB E MUST FINISH HERE
IF RETAINED BY PCB A

THIS SECTION REQUIRED
IF RETAINED BY BASE OF CNMB

SLIDES INTO TOP OF CNMB RETAINED EITHER
BY PCB A or THE CNMB BASE

- - | - | - | | - | - | COLOUR: | DEBURR AND BREAK SHARP EDGES | DO NOT SCALE DRAWING | SCALE: 2:3

GNL ASSY & PCB DRG FOR CNMB
