fullyautomated/means-of-circuit-design/3D/Housing/CNMB_3V_2.PDF

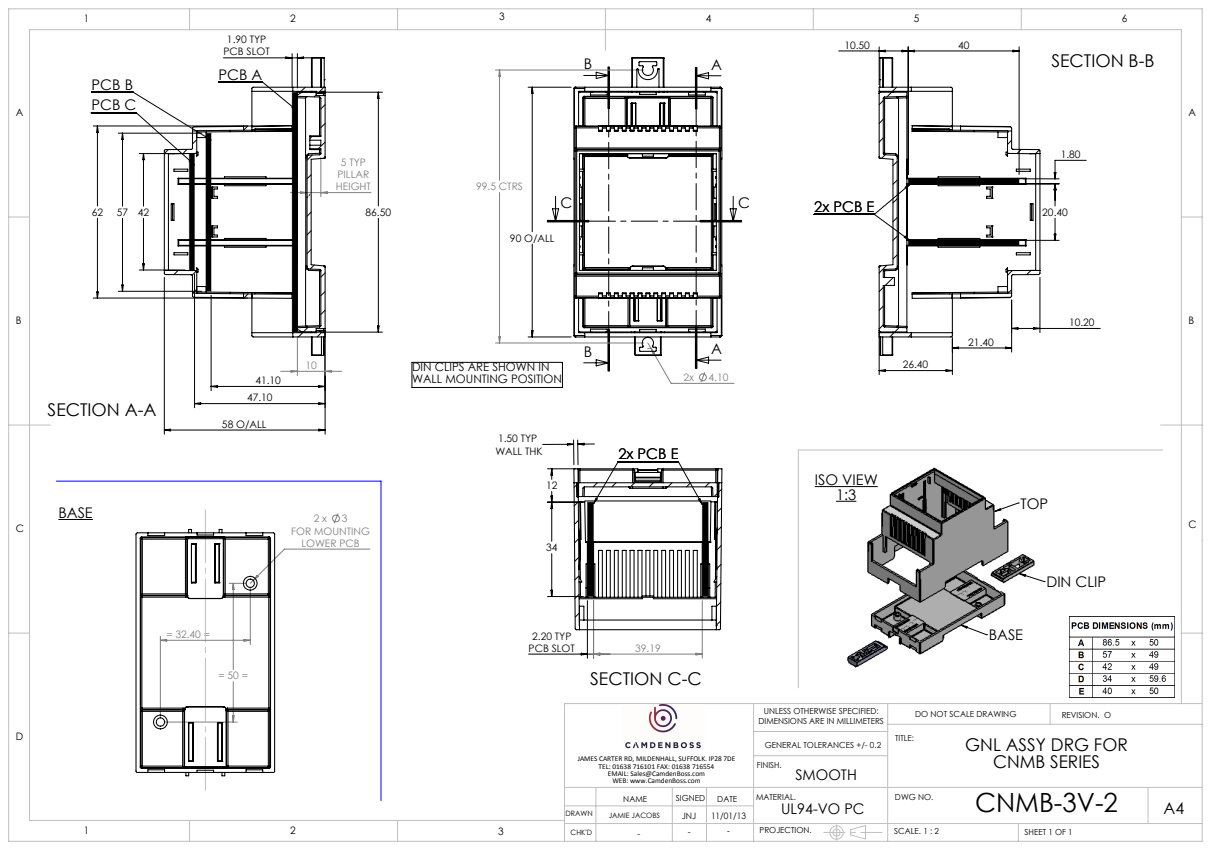
[picture p47: page 1]
ISO VIEW; DIN CLIP; 99.5 CTRS; 90 O/ALL; 5 TYP; 58 O/ALL; 1.90 TYP PCB SLOT; SECTION A-A; PCB A; PCB C; PCB B; SECTION B-B; 2x PCB E2x PCB E; 1.50 TYP WALL THK; 2.20 TYP; PCB SLOT; SECTION C-C; 2 x 3 FOR MOUNTING LOWER PCB; NAME; SIGNED DATE; MATERIAL.; DWG NO.; SCALE. 1 : 2; SHEET 1 OF 1; REVISION. O; JAMIE JACOBS; JNJ; GENERAL TOLERANCES +/- 0.2

DIN CLIPS ARE SHOWN IN
WALL MOUNTING POSITION

UNLESS OTHERWISE SPECIFIED:
DIMENSIONS ARE IN MILLIMETERS

DO NOT SCALE DRAWING
GNL ASSY DRG FOR
CNMB SERIES
CNMB-3V-2

JAMES CARTER RD, MILDENHALL, SUFFOLK. IP28 7DE
TEL: 01638 716101 FAX: 01638 716554 EMAIL: Sales@CamdenBoss.com
WEB: www.CamdenBoss.com
