fullyautomated/means-of-circuit-design/3D/PCIe/10061913.pdf

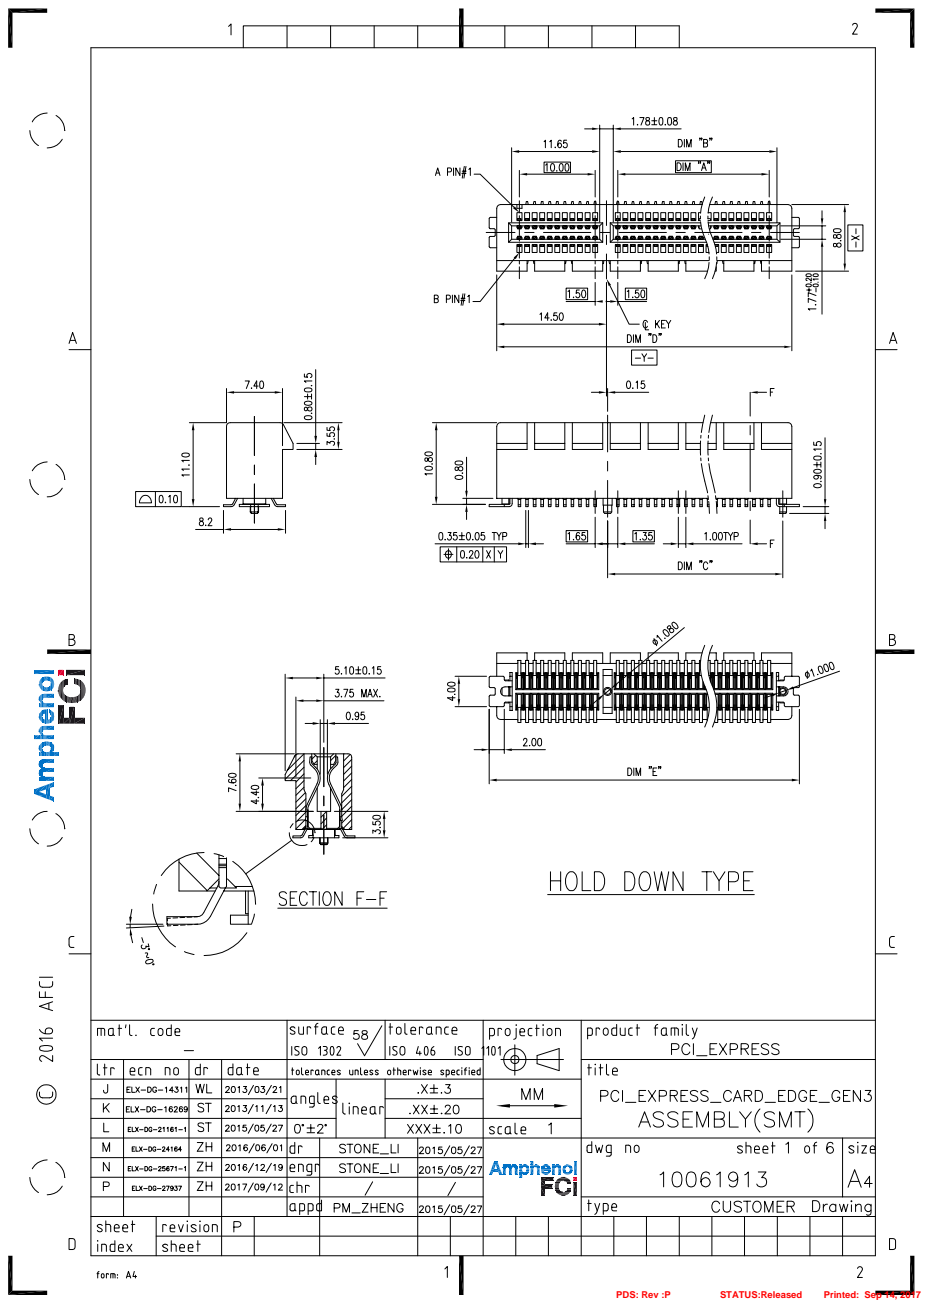
[picture p55: page 1]
PDS: Rev :P; STATUS:Released; Printed: Sep 14, 2017

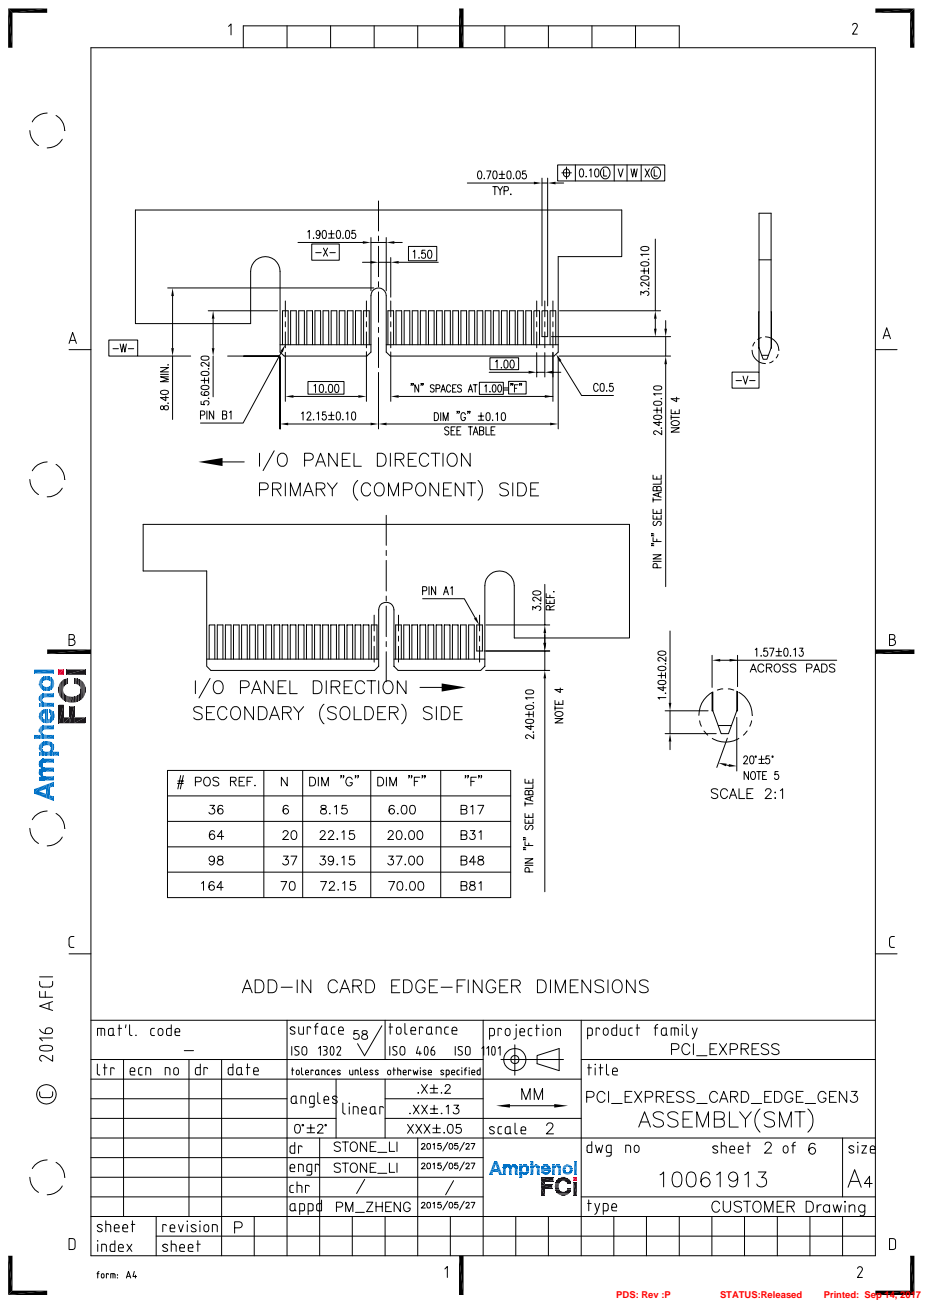
[picture p56: page 2]

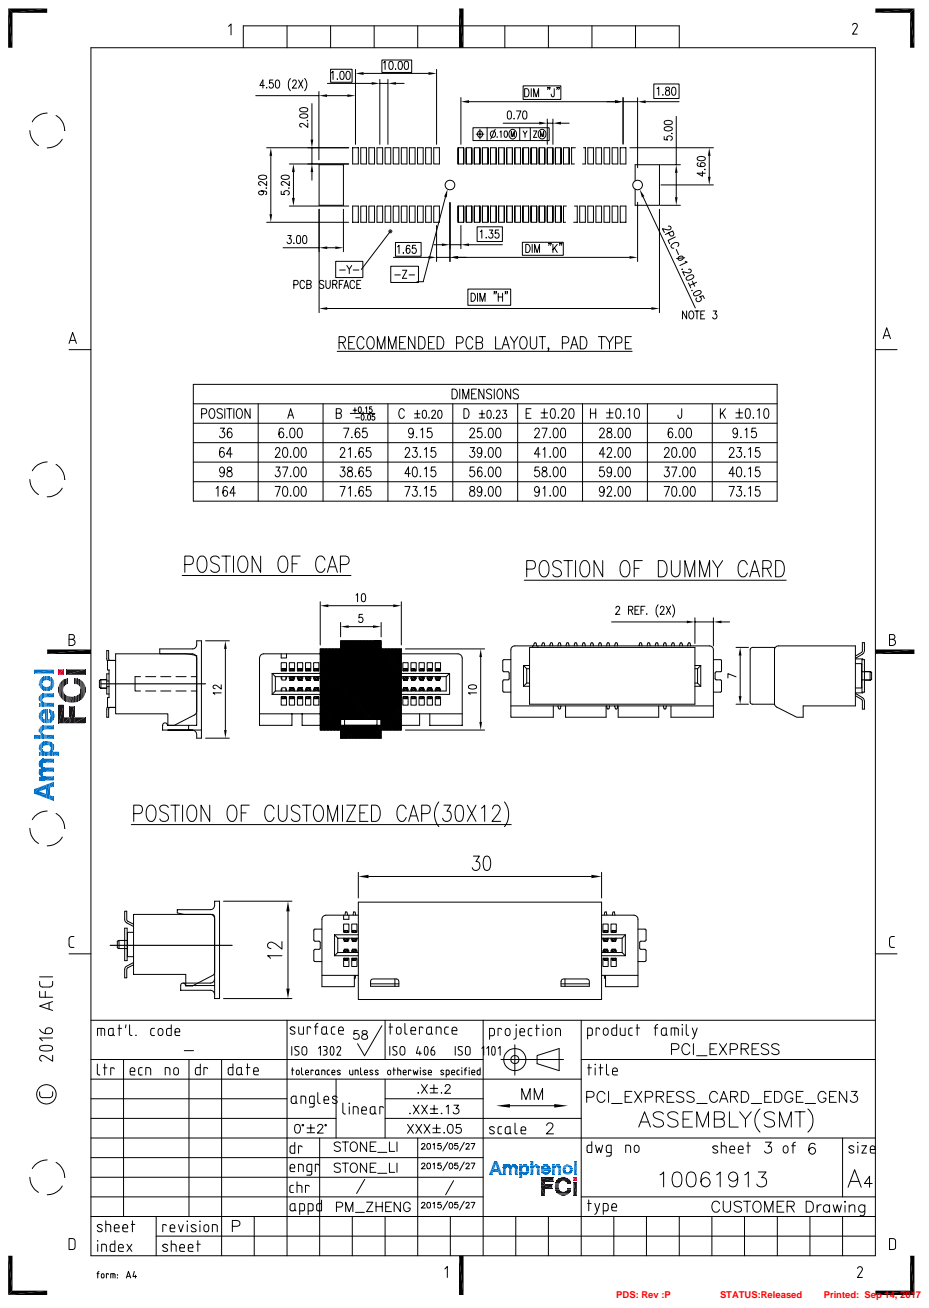
[picture p57: page 3]

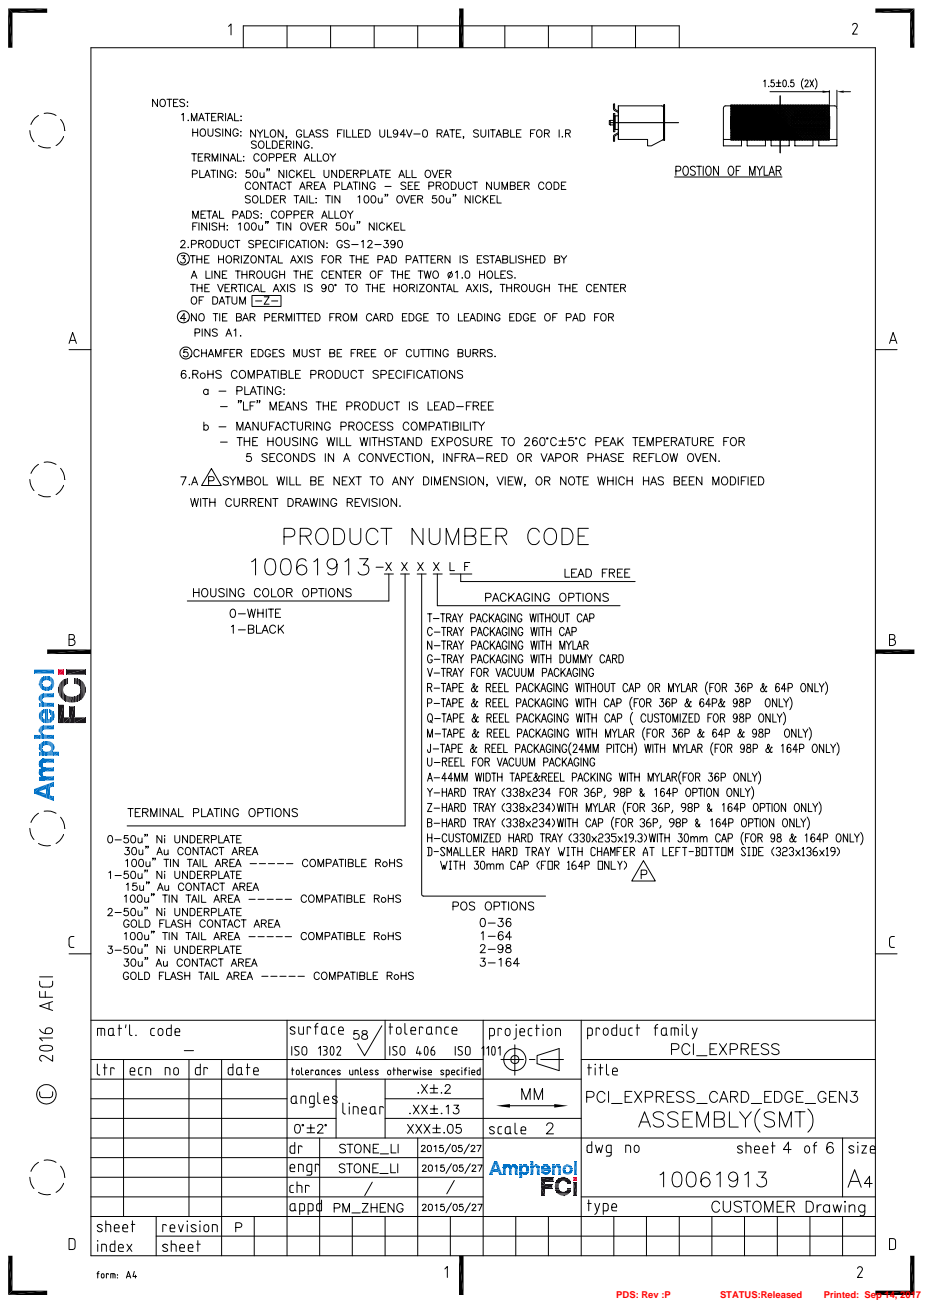
[picture p58: page 4]

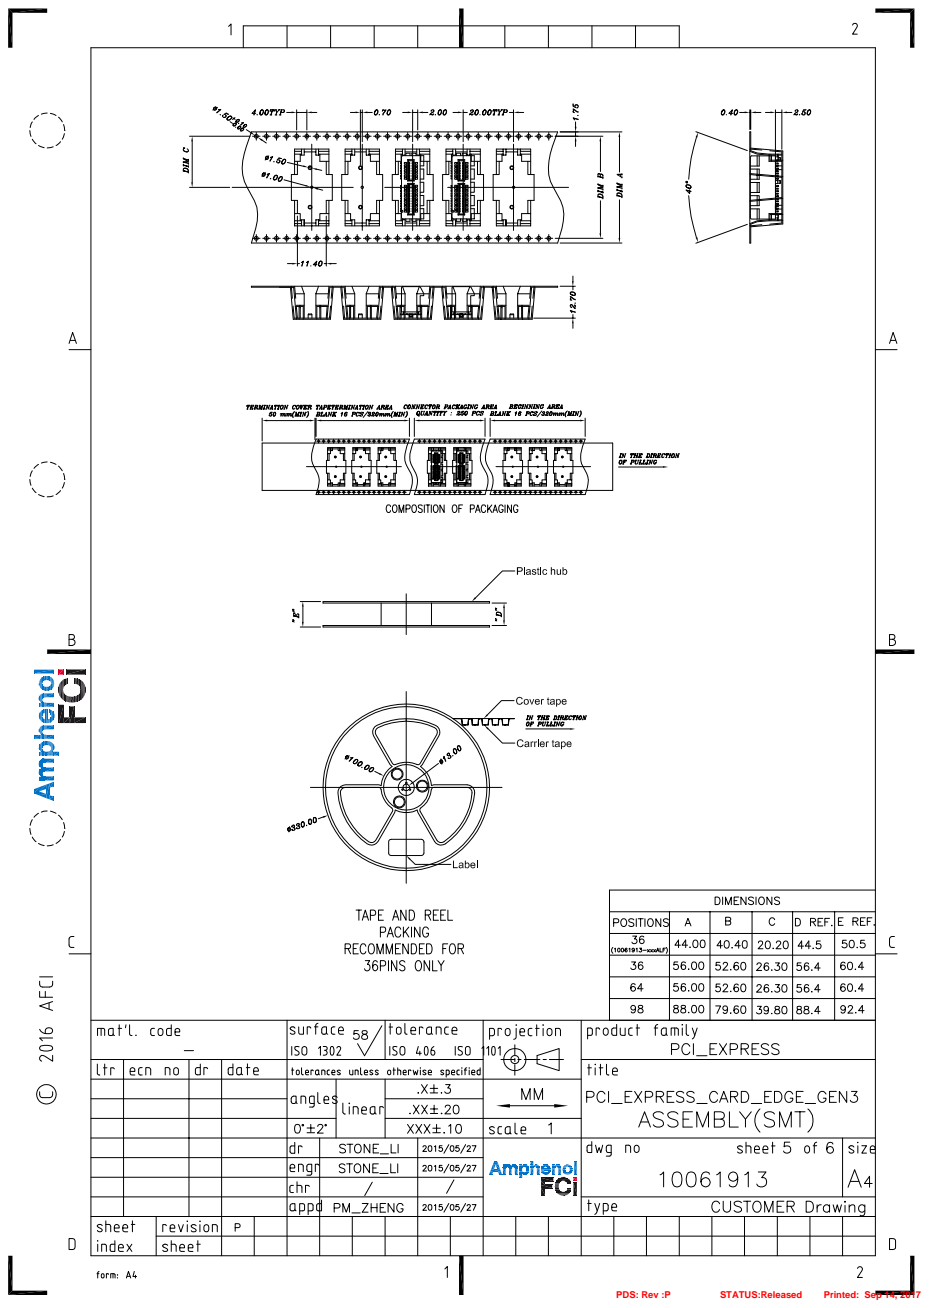
[picture p59: page 5]

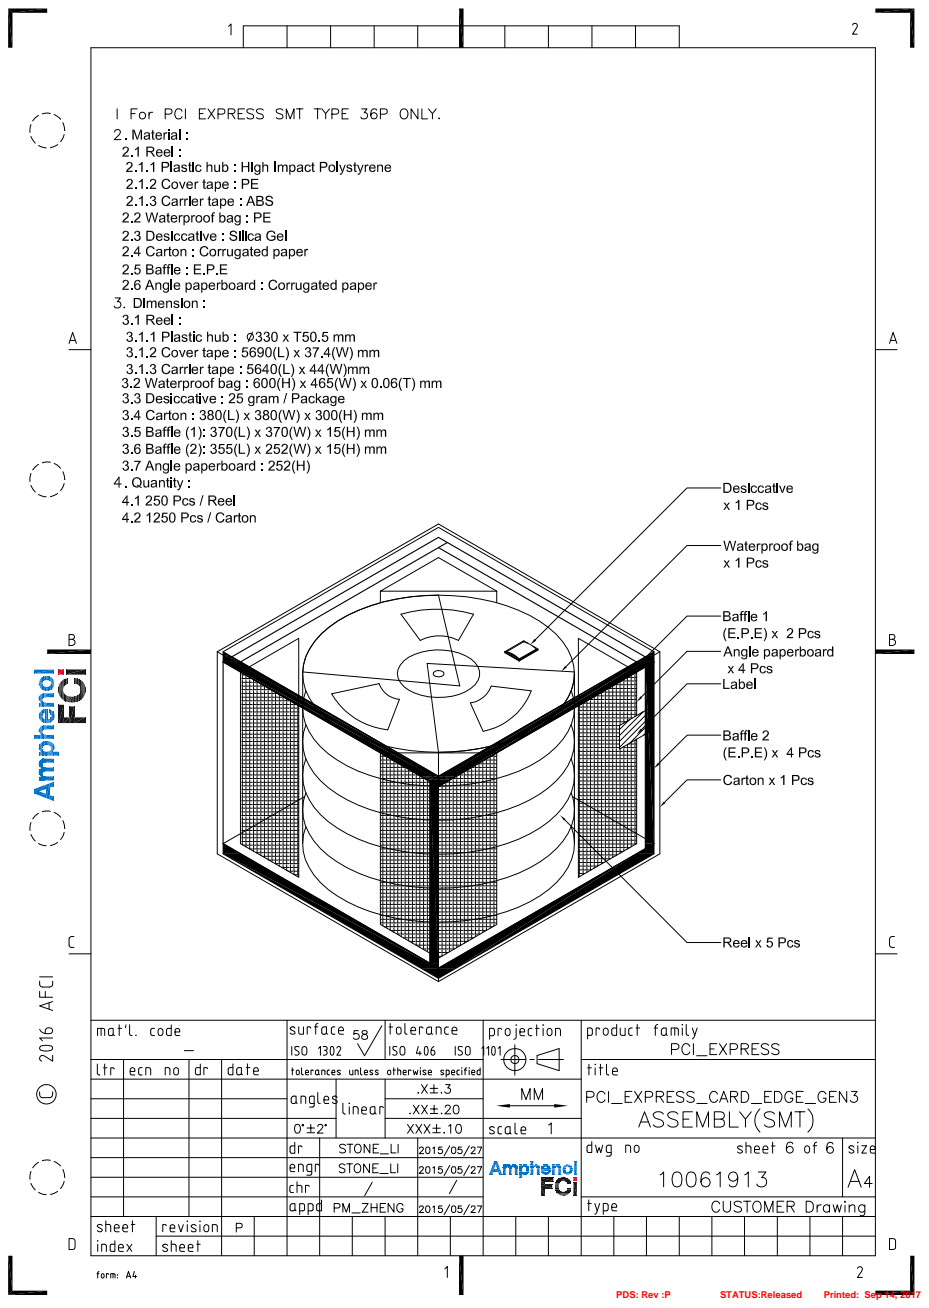
[picture p60: page 6]
