fullyautomated/means-of-circuit-design/(commit log)

2020-06-24 Pull out all the libraries into their own repo
    [2.5mm.FCStd, Body_sp.step, DSOP_Advance.scad, ESP8266-12.FCStd, Fusion001.step, Fusion028.step, M0530M.fcstd, Pad.step]
2020-06-25 Add P2X8C4M64P symbol and footprint
2020-06-29 SRP0420 inductors and pin 1 dot on VQFN-HR11
2020-07-04 Add footprints and symbols
2020-07-15 added air core PCB inductors
2020-07-23 added notes about 3D footprints
2020-07-23 added QFN-20-1EP with custom 3D model made with library.io
    [QFN40P300X300X75-21T170N.obj, QFN40P300X300X75-21T170N.step]
2020-07-23 added proper 3D model for C&Ks witch
    [PTS636.FCStd, PTS636SK50SMTRLFS_cp.step, PTS636SP50SMTRLFS.stp]
2020-07-23 added 3D models
    [Admi4FFDtvdj.step, ConPins_sp.step, HRO_TYPE-C-31-M-12.FCStd, HRO_TYPE-C-31-M-12_source.step, Part.step, PowerPAK_1212-8.FCStd, PowerPAK_1212-8.step, QFN40P300X300X75-21T170N.FCStd]
2020-07-31 added coilcraft inductors (3D)
    [SER2915H.FCStd, SER3018H.FCStd]
2020-07-31 added Camdenboss housing as part
    [SRF1260.FCStd, SRF1260.step]
2020-07-31 split up housing to 2 halves
    [CNMB-3V-2-Top.step, CNMB-CB_Base_cp.step]
2020-07-31 added 3D model
    [PWP0020A.stp]
2020-08-01 new parts!
    [SOT428.FCStd, SOT428.step]
2020-08-02 touched up footprint library to better match best practices
    [Amph_10018783-10210TLF.step, Amphenol_10018783-10210TLF.FCStd, OSRAM_Duris_S5.FCStd, OSRAM_Duris_S5.step]
2020-08-03 added heatsink
    [27-23-D-AB-0.FCStd, WV_27-23-D-AB-0.step]
2020-08-03 modified drill so JLC likes it more
2020-08-03 new models
    [960-23-23-D-AB-0.FCStd, 960-23-23-D-AB-0.step]
2020-08-03 new part
    [tsw-113-08-t-t-ra.FCStd, tsw-113-08-t-t-ra.step]
2020-08-13 added edge mount 2-mm dual row through hole header
    [62002821121_.stp]
2020-08-13 added footprint for AS7341
    [AS7341.FCStd, AS7341.step]
2020-08-18 added LM76005
    [LM76005.FCStd, LM76005_RNP0030A.step]
2020-08-25 new parts
    [LTR-303ALS-01.FCStd, LTR-303ALS-01.step]
2020-10-16 added JLC tooling hole
2020-10-18 Add cheap chinese UVC LED
2020-11-18 add stm32g0{3,7}x symbol
2020-11-19 Fix bq BMS symbol and revise STM32G0 symbol
2020-11-25 Add a neat LED driver
2020-12-17 Add some symbols and footprints
    [DLW5BSM191SQ2L.step]
2021-01-26 added new footprints
2021-01-31 added through-hole 6.3-mm FastON flat connector
    [FastON_6.3mm_PCBmount_RightAngle_Osterrath_61-1573-11_0031.FCStd, FastON_6.3mm_PCBmount_RightAngle_Osterrath_61-1573-11_0031.step]
2021-02-09 added 20-pin test pad
2021-02-09 added more test pad footprints
2021-02-12 added millmax THT pogo pins
2021-02-14 Add LM301H model and footprint
    [LM301H.FCStd, LM301H.step]
2021-02-14 Add Würth 7466205
    [7466205.FCStd, 7466205.step]
2021-02-14 Add TO-220SM(W) 3D model
    [TO-220SM(W).FCStd, TO-220SM(W).step]
2021-02-28 Add STM32G0B1CC
2021-03-01 Add a side-mount SPST SMD switch
2021-05-03 Add some symbols and a TI package model
    [RPE0009A.FCStd, RPE0009A.step, RPE0009A.stp]
2021-05-05 added inductors and weird TI hotrod
    [Coilcraft-SER2211.step, SER2211.FCStd, SRR5028.FCStd, SRR5028.step]
2021-05-16 Add CN3300 and a bunch of footprints
2021-05-20 Add STM32G0xxFxx
2021-06-04 add some parts
    [79527141.FCStd, 79527141.stp]
2021-12-30 Convert to KiCAD 6
    Old symbols will be kept around for a bit, new symbols only for KiCAD 6
2024-07-28 add some more symbols and footprints
2024-10-07 add Diodes UXC kelvin footprint
2025-09-25 add some more footprints and symbols
    symbols: TXE8116, ADBMS1818, RES60A, DG604E
    footprints: NFM21xC, weird LQFP for ADBMS1818, weird SOIC, Vishay CDMA resistor divider, improve Texas RGX package, weird Texas VSSOP
2025-11-27 add SOT1255-2 footprint
2025-12-01 add 1206 current sense shunt footprint
2026-10-10 a bunch of new footprints and symbols
2026-10-12 split out symbols into kicad_sym files
